qq2898498192-prog/codex/README.md

# Microduck 完整工程

## [进入完整工程 microduck_rl/](microduck_rl/)

已完整复制来源分支的 **253 个文件**，包括全部源码、STL、MJCF、图片、Gerber、BOM、贴片坐标、固件、测试、依赖文件、文档和许可证。保持原始目录、文件内容和文件模式。

- 来源：https://github.com/atrl/microduck_rl/tree/codex/organize-robot-assets-20260830
- 固定提交：`57280a07b06f7356500b796c8ddcda66008908d2`
- [文件 SHA-256 清单](MICRODUCK_IMPORT.json)
- Git 树校验：`microduck_rl/` 的树 SHA 为 `ccd966b7c30a4be1f8063402e468bb5402f9c3f4`，与来源提交根目录完全一致。

| 内容 | 入口 |
|---|---|
| 原工程说明及运行方式 | [README](microduck_rl/README.md) |
| 机器人模型、STL 与装配配置 | [模型目录](microduck_rl/src/mjlab_microduck/robot/microduck/) |
| 原理图图片、硬件 BOM 与接线 | [硬件目录](microduck_rl/docs/hardware/) |
| Gerber、贴片 BOM 与坐标 | [制造文件](microduck_rl/docs/hardware/manufacturing/) |
| IMU 固件 | [firmware](microduck_rl/firmware/) |
| 训练与仿真源码 | [src](microduck_rl/src/) |

本次复制的是指定分支提交的完整文件快照，不包含原仓库 Git 历史及外部 Onshape 文档本体。工程原有的未验证事项和许可保持不变；复制成功不代表已完成硬件制造验证。此前 references/ 中的部分摘录已由这里的完整工程取代。

## 新版宠物机器人设计（2026-09-09）

[新方案、效果图、修改与对话记录](projects/microduck-pet-v2/README.md)。当前为概念和布局归档，尚未完成高还原度CAD与交互装配模型。
