qq2898498192-prog/codex/references/microduck/README.zh-CN.md

# 已迁移到完整工程

## [打开完整 microduck_rl 工程](../../microduck_rl/)

指定分支固定提交 `57280a07b06f7356500b796c8ddcda66008908d2` 的 253 个文件已全部复制，包含 STL、图片、Gerber、贴片文件及完整代码。文件内容、目录和模式已通过 Git 树 SHA 核对。

当前目录中的 upstream 是早期部分摘录，个别文档经过删节；请以根目录 microduck_rl 中的完整原始文件为准。

[来源与完整性说明](../../README.md) · [文件校验清单](../../MICRODUCK_IMPORT.json)
