qq2898498192-prog/codex/projects/microduck-pet-v2/animation/README.md

# 视频复现
依赖Python、numpy、Pillow和系统ffmpeg。
`python render.py --font /path/to/NotoSansSC-Regular.ttf`
字体需自行提供有中文的合法字体；缺少中文字体可能出现方框。
轮滚子仅简化面片，不能按此做轮子。
