qq2898498192-prog/codex/projects/microduck-pet-v2/docs/CONVERSATION.md

# 新方案对话记录（可见内容整理）

归档日期：2026-09-09。

范围：机器人新ID、屏幕头、轮组、内部装配及交互爆炸阶段。下面引号中的用户句子按当前可见对话保留；“助手摘要”是归档整理，不冒充逐字回复。没有完整平台原始导出、每条时间戳或不可见的历史回复；未保存工具内部信息、授权凭据和本项目无关的个人历史。

## 起点与造型迭代

用户：
> OK，我现在不想完全复刻这个产品了，我希望从这里给一些启发和借鉴，并且想做另外一种玩具机器人，大体上就是，相比于双腿行走，我希望用四向转向轮，然后带一个屏幕可以显示表情，信息等等，带一个摄像头可以跟踪人，带一个跟鸭子一样的激光雷达。你先帮我设计一个大体的ID，我们再讨论改进

用户：
> 不想要这样的，我希望你能参考鸭子的想法，做一个宠物类的，而不是一个儿童玩具

用户：
> 好丑，你还是参考鸭子吧，做成可以直立行走的，并且是可行的，你这种ID不现实也不美观

用户：
> 更丑了

用户：
> 你还是用之前的鸭子的形象，只不过换一个头，头上多一个小尺寸的屏幕

助手摘要：尝试多个造型均未获认可，回到原版鸭子的身体、长颈和机械双腿，在额头加小屏。

用户：
> 继续

用户：
> 不要长这样的摄像头放小，屏幕大一点

助手摘要：缩小摄像头到屏幕上方，扩大屏幕，生成外观概念；未按实物模组冻结结构。

用户：
> 你要考虑模组的大小

助手摘要：承认之前仅外观效果，没有摄像头/屏幕整板、排线与安装结构约束。

用户：
> 你继续去设计

助手摘要：查阅屏幕79.9×50.8、摄像头25×24、ToF载板资料，制作头部V1正面与侧向布局；暂定头部110×92×80，不是可生产CAD。

用户：
> 设计效果呢

助手摘要：生成更宽黑色边框的屏幕头效果，显示区与模组整板区分。

## 轮子方案

用户：
> 这个鸭子有个轮子的方案，把脚换成他的轮子方案

助手摘要：参照仓库轮滑装配渲染生成效果图，声称每脚两个前后轮。

用户：
> 你确定这是他原来的方案吗，不是长这样的

助手摘要：承认AI图不是原版精确还原；检查robot_allcollisions_rollers.xml确认四个passive轮轴，仅能说明给定分支的配置。展示由STL/MJCF直接渲染的参考。

用户：
> 头先用回摄像头版本，脚不要舵机了做成万向轮

助手摘要：恢复摄像头头部，取消脚踝舵机，改固定脚架和4个被动万向脚轮；说明被动脚轮不供驱动力。

用户：
> 这样还是太丑了，整个脚的部分加装电机，改成大的麦克纳姆轮

助手摘要：生成四轮独立电机麦克纳姆足端，电机藏入轮罩；仍是外观概念。

用户：
> 腿部需要安装电机和线束，要重新设计，头换成屏幕方案，电机型号你要根据实际可能得重量去设计，头的嘴就不需要了，也不需要用舵机了

助手摘要：按取消嘴部舵机理解，暂保留头部俯仰与转向；查阅Pololu4846，按3kg和80mm轮初选，增加腿壳/横撑/走线。此处保留俯仰随后被用户明确纠正。

用户：
> 轮子太大了，选用小轮子吧

助手摘要：按约60mm比例生成小轮图；不代表最终型号和尺寸已锁定。

用户：
> 没有区别啊，把头的嘴巴去掉，头不需要前后前仰了，只要左右能扭头就行了。你做一个演示视频出来

助手摘要：改为头壳无独立下颌、竖直单轴转台。制作10秒、240帧、1280×900的简化三维转头视频，左右±35°，不做点头；不是此前图片精度的动画。

## 内部器件与爆炸图

用户：
> 你做一个爆炸图，包括内部器件的摆放位置，如果你没有考虑到或者漏了你就重新设计

助手摘要：补齐主控、电池、配电、脚部驱动板、转台执行器/承重轴承、轮轴/联轴器、检修与线束空间；生成42项包络布局。电机横置导致底宽294mm，重量预算改3.5kg。部分器件仅占位；无完整CAD、PCB、STL。

用户：
> 要整个效果的爆炸图纸

助手摘要：生成整机视觉爆炸图。第一张错误生成8轮，后续改成4轮。图中连接、紧固和机械细节仍为生成式示意，无对应精确CAD。

用户：
> 能不能做成那种原本是一个整体，然后我拖动可以打开整体或者部分地方的爆炸效果的

助手摘要：制作Three.js简化模型，默认装配、选择整机/头/转台/躯干/左右腿脚、滑块展开、旋转/缩放、一键复位。只验证JS与桩环境回调，未跑真实WebGL浏览器验证。

用户：
> 我要基于这个做的拖动爆炸效果图

附件：用户重新贴出整机爆炸效果图，对应本归档 concepts/exec-45c2b3f4-eb2d-42fb-9c85-e57055dfe0b6.png 的视觉目标。

助手摘要：明确用户要同一外观和内部零件形状的交互模型，之前简化模型不符合要求。承认效果图背后没有对应真实三维件，必须重建；切块图片移动不能替代真实可旋转装配。

## GitHub归档授权

用户：
> 你把新的设计方案放进我的github上，也可以建立一个新的分支，并且需要把修改和对话记录放进github上

用户随后重复同一请求。

助手归档范围：用户仓库qq2898498192-prog/codex，新分支codex/screen-mecanum-design-20260909；保留新方案、历史图、布局和演示源码、修改日志、对话整理、未完成清单。没有完成/声称高还原度三维重建，也不改动原microduck_rl工程。
