qq2898498192-prog/codex/projects/microduck-pet-v2/scripts/archive/README.md

历史生成脚本原样存档；含会话绝对路径，复现前需调整字体/路径。layout/中的产物为归档事实。不要运行脚本覆盖新设计。
