qq2898498192-prog/codex/microduck_rl/docs/hardware/imu_to_dxl_v0_schematic.png

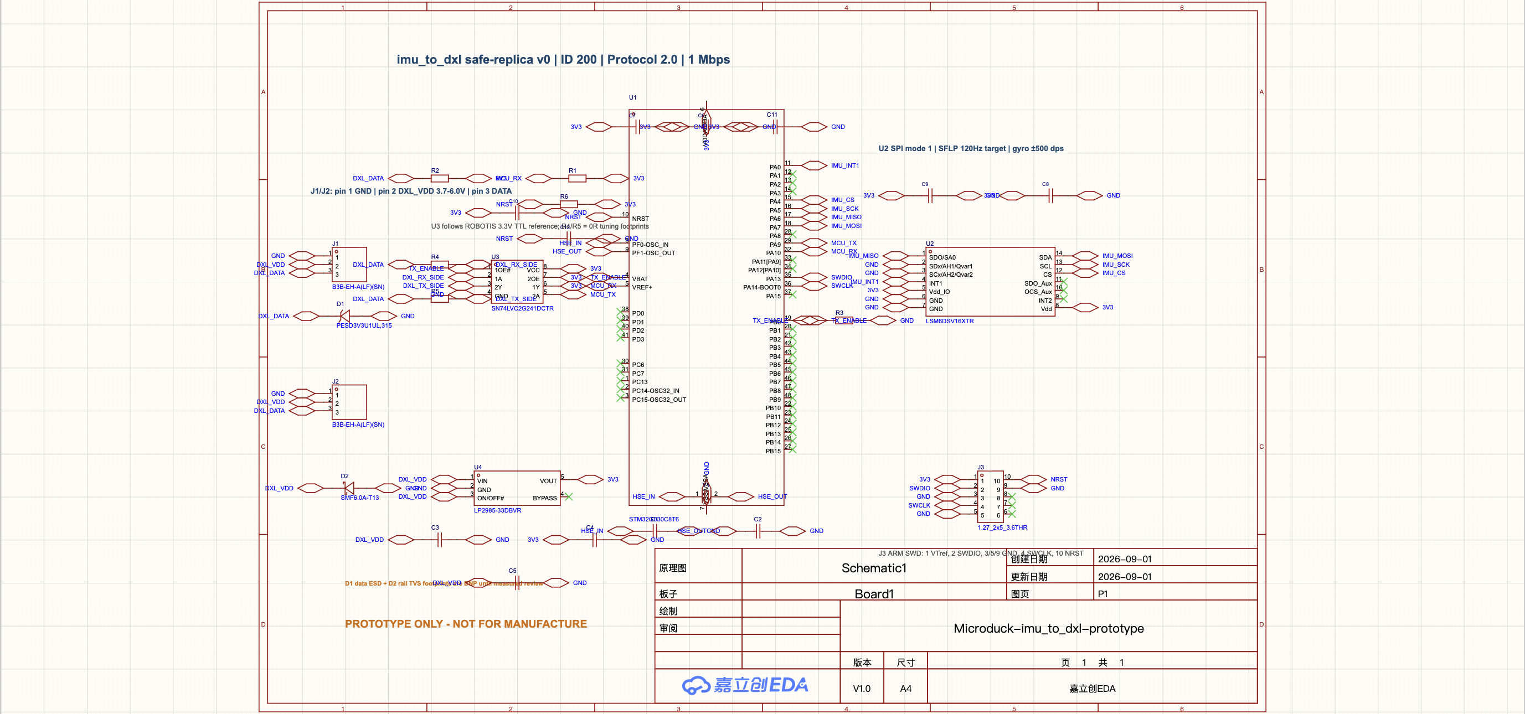
microduck_rl/docs/hardware/imu_to_dxl_v0_schematic.png
