qq2898498192-prog/codex/projects/microduck-pet-v2/animation/preview.png

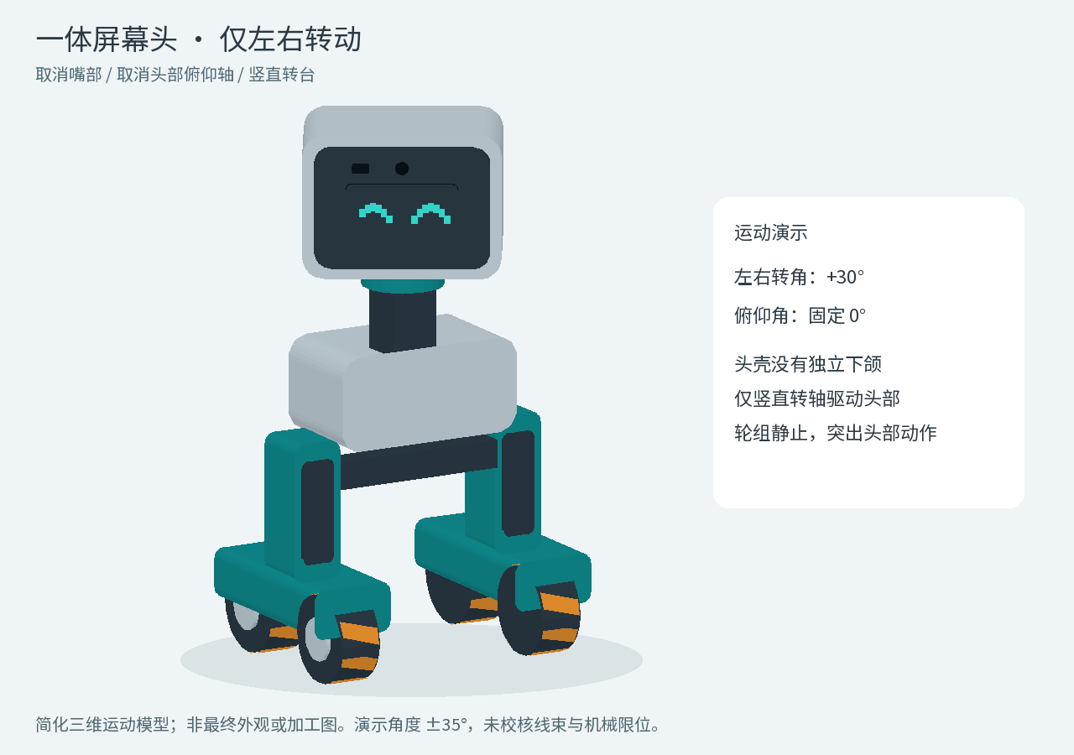
projects/microduck-pet-v2/animation/preview.png
