qq2898498192-prog/codex/projects/microduck-pet-v2/concepts/exec-0cad2724-1c27-4ab0-85ad-87070f33ec14.png

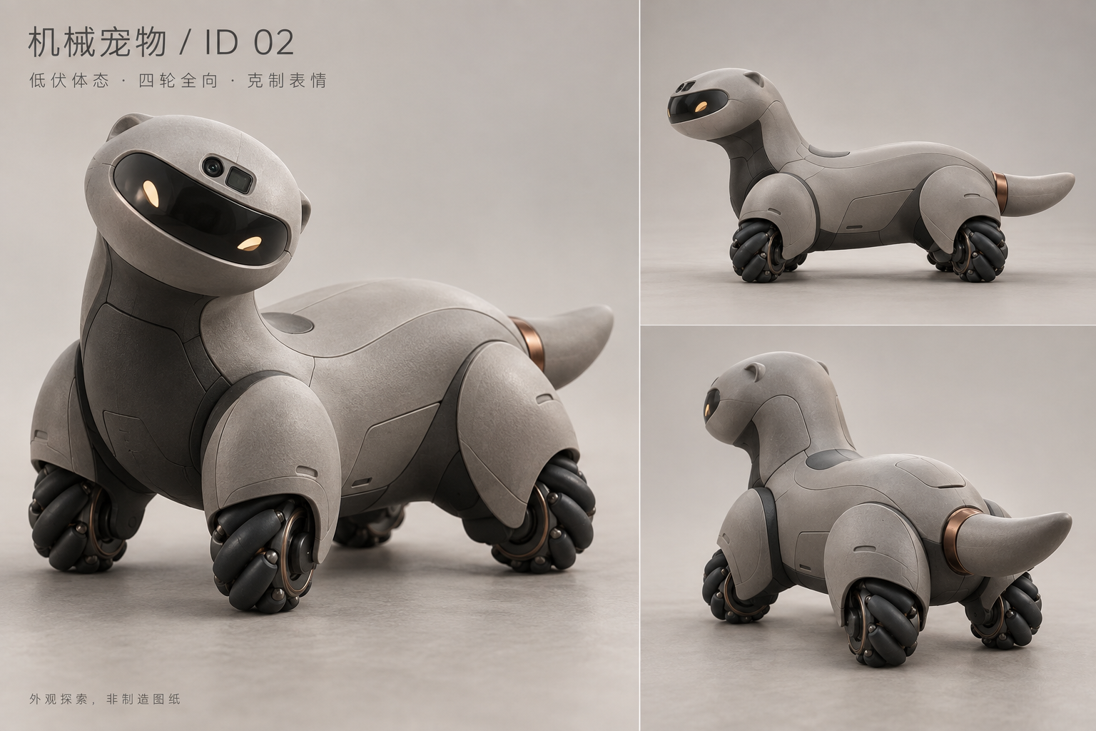
projects/microduck-pet-v2/concepts/exec-0cad2724-1c27-4ab0-85ad-87070f33ec14.png
