qq2898498192-prog/codex/projects/microduck-pet-v2/concepts/exec-01a4c43e-ca88-4873-aa00-53a5d9657a6b.png

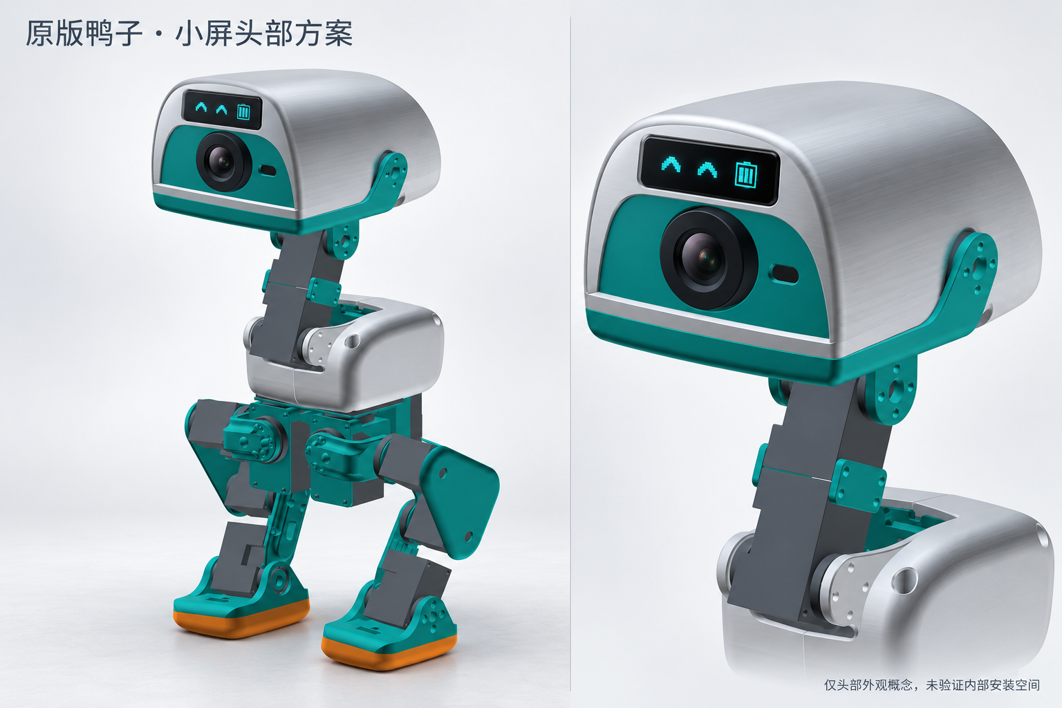
projects/microduck-pet-v2/concepts/exec-01a4c43e-ca88-4873-aa00-53a5d9657a6b.png
