qq2898498192-prog/codex/projects/microduck-pet-v2/concepts/exec-12abe6a6-0537-42fc-a870-e68644018d23.png

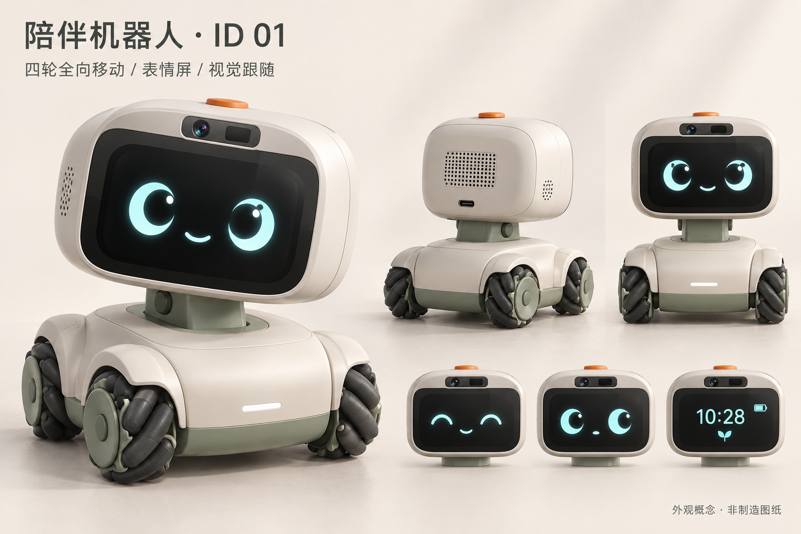
projects/microduck-pet-v2/concepts/exec-12abe6a6-0537-42fc-a870-e68644018d23.png
