qq2898498192-prog/codex/projects/microduck-pet-v2/concepts/exec-36e8b0e3-2273-436e-a0a7-a6f0dd408338.png

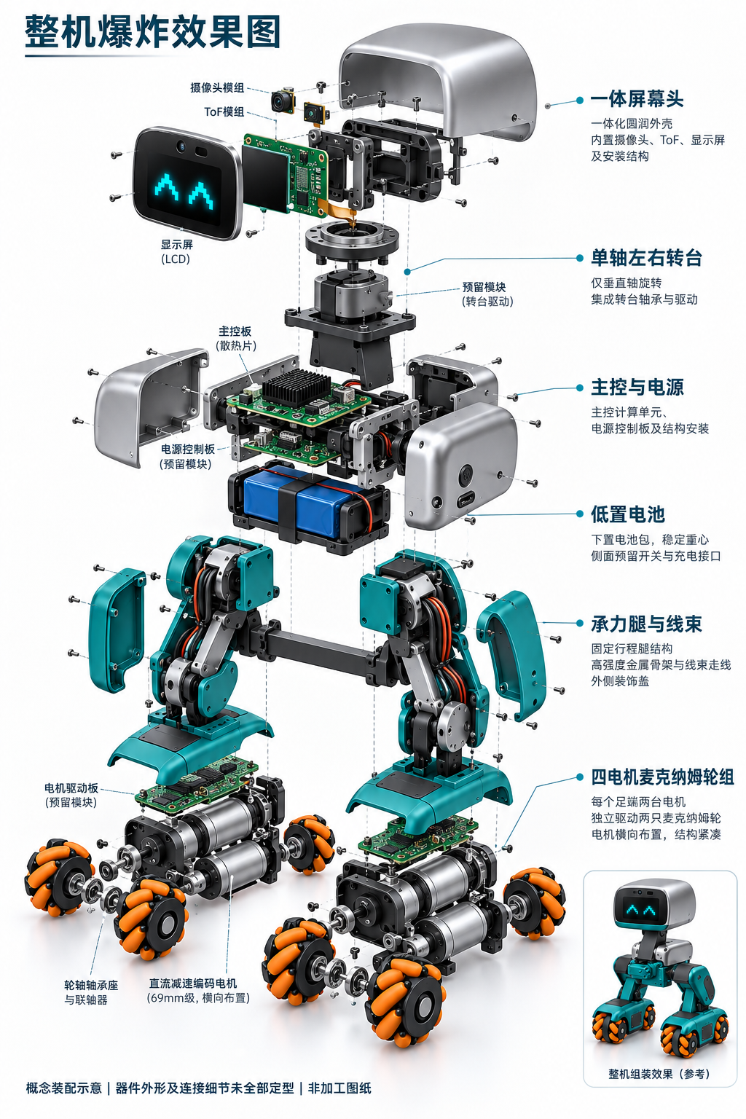
projects/microduck-pet-v2/concepts/exec-36e8b0e3-2273-436e-a0a7-a6f0dd408338.png
