qq2898498192-prog/codex/projects/microduck-pet-v2/concepts/exec-545a0076-77d6-4a2a-9751-2d3e98dc3354.png

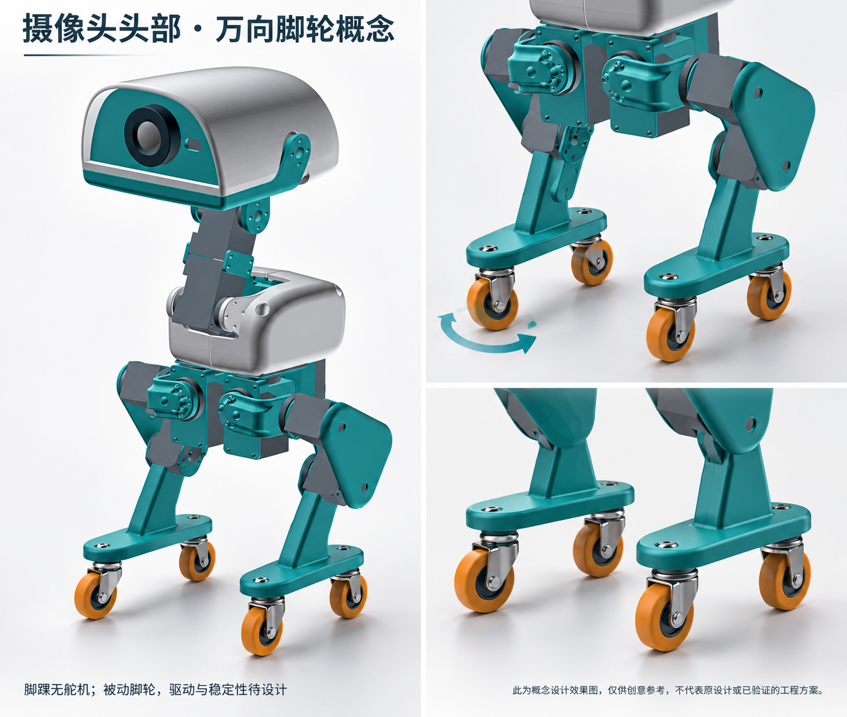
projects/microduck-pet-v2/concepts/exec-545a0076-77d6-4a2a-9751-2d3e98dc3354.png
