qq2898498192-prog/codex/projects/microduck-pet-v2/concepts/exec-1944f9b6-d83f-42fd-b372-9bee85fd1d9c.png

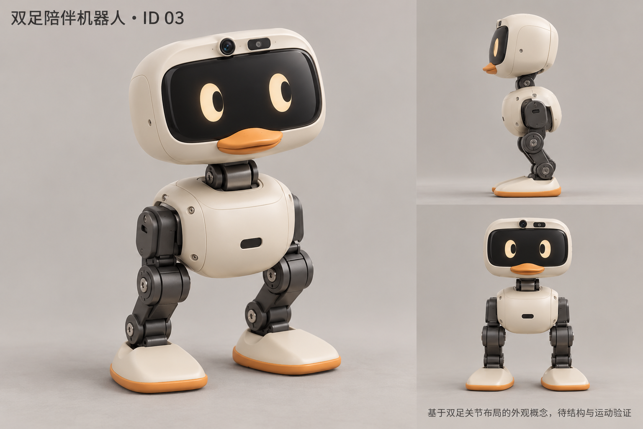
projects/microduck-pet-v2/concepts/exec-1944f9b6-d83f-42fd-b372-9bee85fd1d9c.png
