qq2898498192-prog/codex/projects/microduck-pet-v2/concepts/exec-84887840-35ca-4b33-ac52-a1b6fc9ca3c3.png

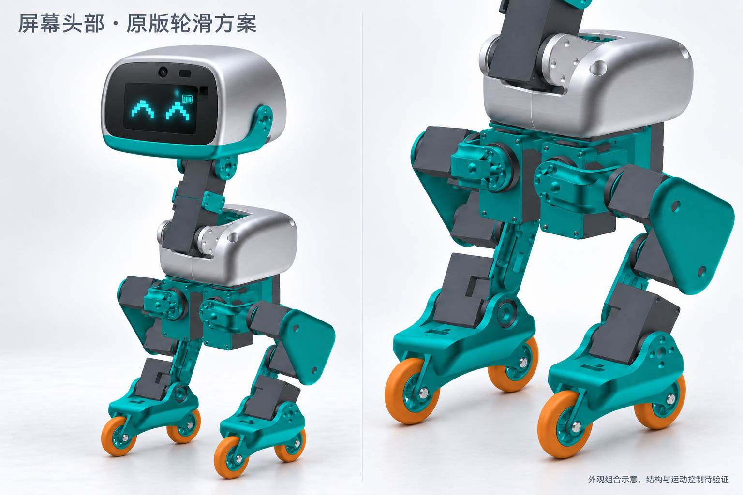
projects/microduck-pet-v2/concepts/exec-84887840-35ca-4b33-ac52-a1b6fc9ca3c3.png
