qq2898498192-prog/codex/projects/microduck-pet-v2/concepts/exec-c1b9ecd1-bf93-4650-8cc1-9218ce18c52f.png

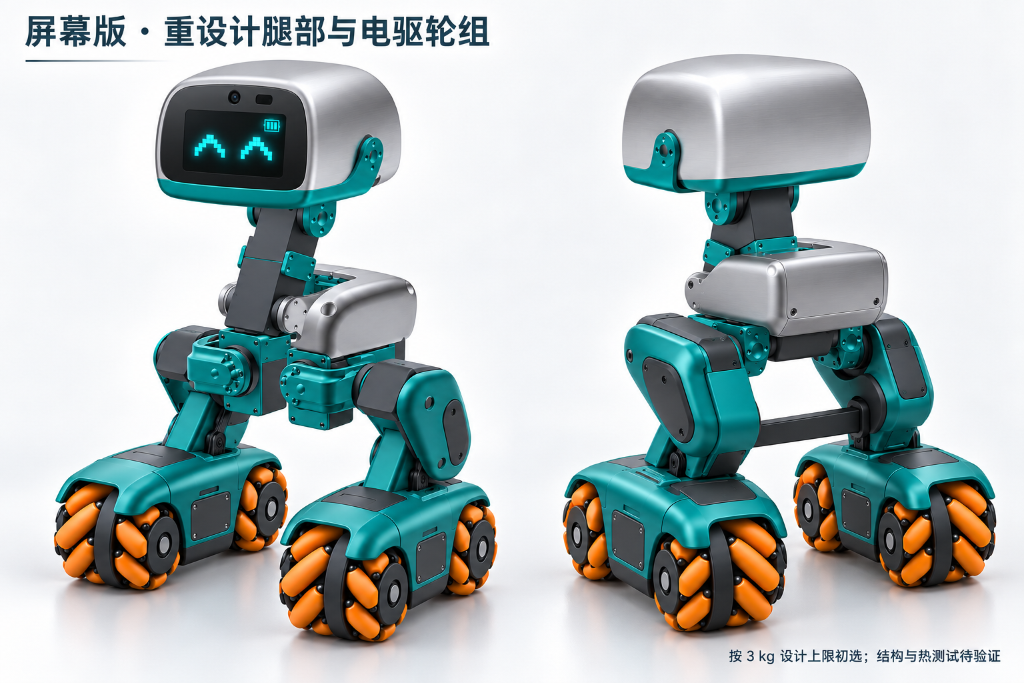
projects/microduck-pet-v2/concepts/exec-c1b9ecd1-bf93-4650-8cc1-9218ce18c52f.png
