qq2898498192-prog/codex/projects/microduck-pet-v2/concepts/exec-c386e710-e0e7-46d0-af4a-2715de877a2f.png

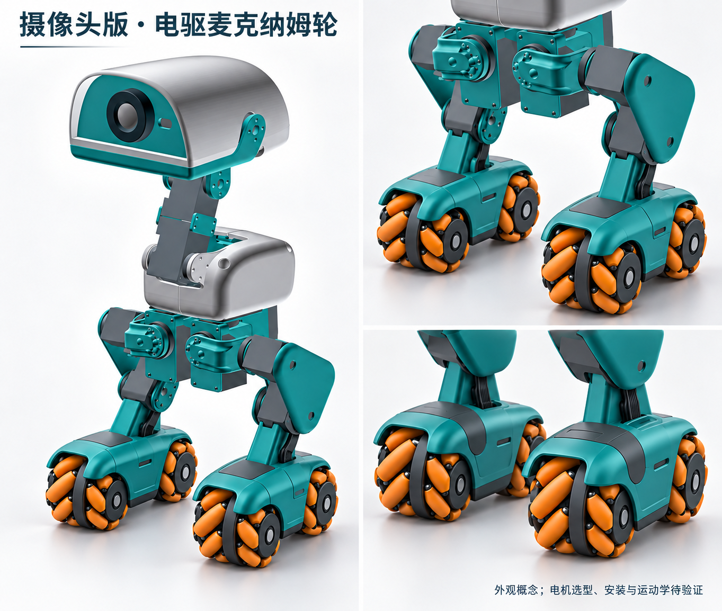
projects/microduck-pet-v2/concepts/exec-c386e710-e0e7-46d0-af4a-2715de877a2f.png
