qq2898498192-prog/codex/projects/microduck-pet-v2/concepts/exec-febafb0e-33c4-49e8-8c32-e0713513a3d7.png

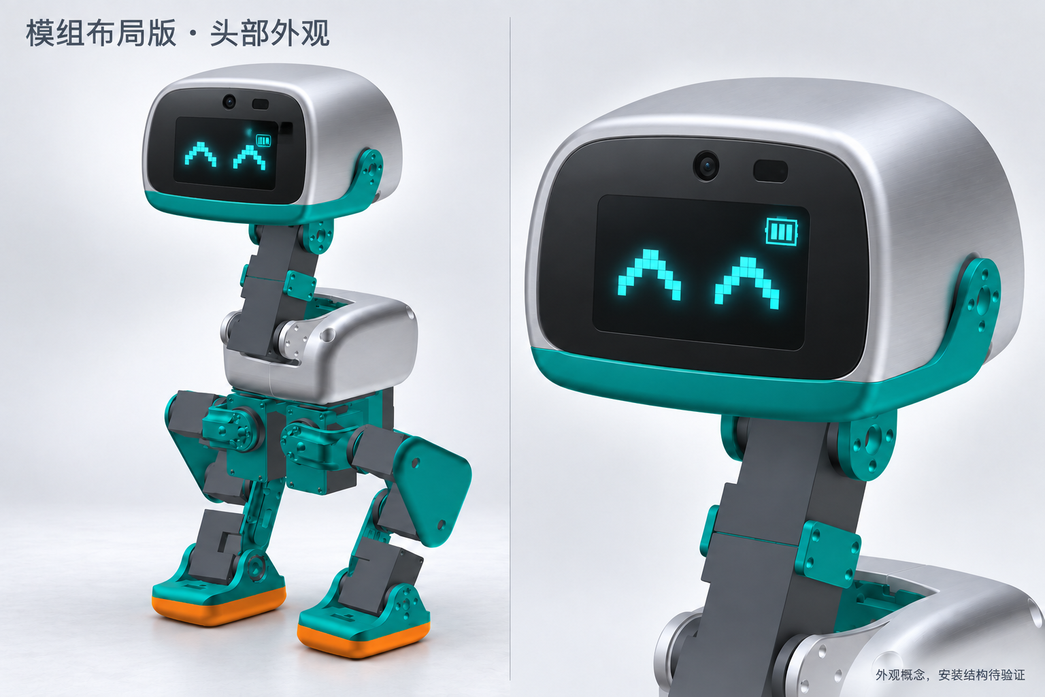
projects/microduck-pet-v2/concepts/exec-febafb0e-33c4-49e8-8c32-e0713513a3d7.png
