qq2898498192-prog/codex/projects/microduck-pet-v2/layout/Exploded_Preview.png

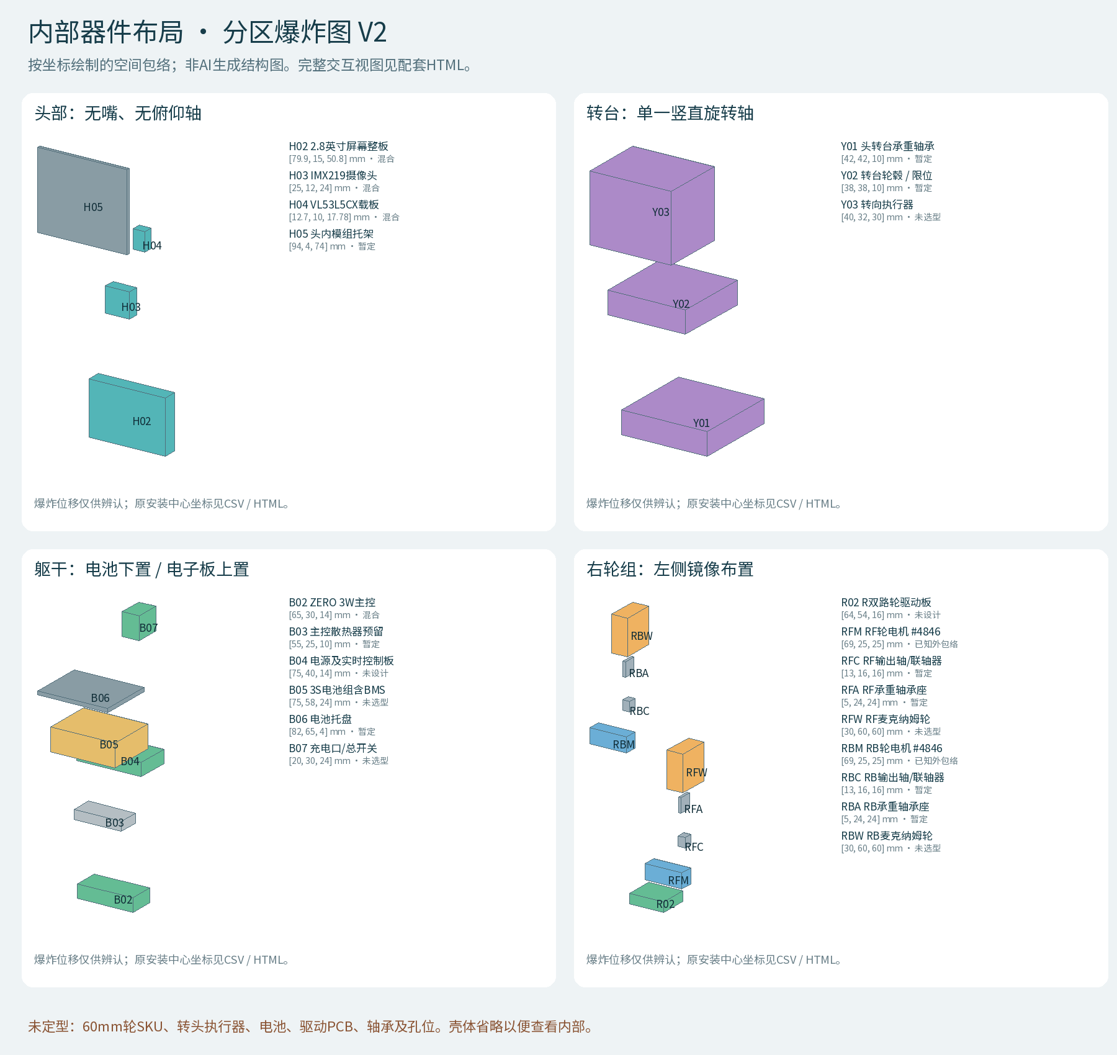
projects/microduck-pet-v2/layout/Exploded_Preview.png
