qq2898498192-prog/codex/microduck_rl/docs/hardware/reference_bom.csv

item_id | variant | subsystem | item_name | specification | source_asset | procurement_class | status | confidence | verification_gate | source_url | notes
M008 | both | electronics | Robot HAT PCB envelope | Reference geometry only | elec_rpi_robot_hat_pcb.stl | reference_only | reference_only | medium | Compare replacement HAT outline and hole locations | https://github.com/pollen-robotics/microduck_rl/tree/develop/src/mjlab_microduck/robot/microduck/assets | Do not print as a PCB
M016 | both | legacy | Older left upper leg export | Unreferenced legacy mesh | left_upper_leg.stl | legacy | legacy | high | Confirm it stays unused | https://github.com/pollen-robotics/microduck_rl/tree/develop/src/mjlab_microduck/robot/microduck/assets | Do not print for current assemblies
M018 | both | electronics | Camera lens envelope | Reference geometry only | lens.stl | reference_only | reference_only | low | Confirm actual camera and lens before purchase | https://github.com/pollen-robotics/microduck_rl/tree/develop/src/mjlab_microduck/robot/microduck/assets | May represent prototype M12 optics
M024 | both | power | NP-F battery envelope | NP-F970 reference envelope | np_f970.stl | reference_only | reference_only | medium | Select NP-F550 or NP-F970 after mass and clearance test | https://github.com/pollen-robotics/microduck_rl/tree/develop/src/mjlab_microduck/robot/microduck/assets | Runtime names NP-F550 while the mesh is NP-F970
M025 | both | electronics | Raspberry Pi Zero 2 W envelope | Prototype reference only | pcb__raspberry_pi_zero_2_w.stl | reference_only | reference_only | high | Do not purchase for current runtime target | https://github.com/pollen-robotics/microduck/blob/main/docs/design/robotd-design.md | Current alpha runtime uses Radxa Zero 3W
M028 | both | legacy | Older right upper leg export | Unreferenced legacy mesh | right_upper_leg.stl | legacy | legacy | high | Confirm it stays unused | https://github.com/pollen-robotics/microduck_rl/tree/develop/src/mjlab_microduck/robot/microduck/assets | Do not print for current assemblies
M040 | both | legacy | Older left trunk shell export | Unreferenced legacy mesh | trunk_shell_left.stl | legacy | legacy | high | Confirm it stays unused | https://github.com/pollen-robotics/microduck_rl/tree/develop/src/mjlab_microduck/robot/microduck/assets | Do not print for current assemblies
M041 | both | legacy | Older right trunk shell export | Unreferenced legacy mesh | trunk_shell_right.stl | legacy | legacy | high | Confirm it stays unused | https://github.com/pollen-robotics/microduck_rl/tree/develop/src/mjlab_microduck/robot/microduck/assets | Do not print for current assemblies
