qq2898498192-prog/codex/microduck_rl/docs/hardware/microduck_bom.csv

item_id | variant | subsystem | item_name | specification | source_asset | base_qty | roller_qty | purchase_qty | unit | procurement_class | status | confidence | verification_gate | source_url | notes | buy_status | preferred_url | alternate_url | link_type | link_checked_on | next_action | purchase_notes
M001 | roller | feet | Roller left ankle | Simulation-derived rigid print | ankle_l_v1.stl | 0 | 1 |  | piece | print_rigid | confirmed_model | medium | Fit-check against servo and roller chassis | https://github.com/pollen-robotics/microduck_rl/tree/develop/src/mjlab_microduck/robot/microduck/assets | Roller model only
M002 | walking | feet | Walking left ankle | Simulation-derived rigid print | ankle_left.stl | 1 | 0 |  | piece | print_rigid | confirmed_model | medium | Fit-check bearing and servo interfaces | https://github.com/pollen-robotics/microduck_rl/tree/develop/src/mjlab_microduck/robot/microduck/assets | Walking model only
M003 | roller | feet | Roller right ankle | Simulation-derived rigid print | ankle_r_v1.stl | 0 | 1 |  | piece | print_rigid | confirmed_model | medium | Fit-check against servo and roller chassis | https://github.com/pollen-robotics/microduck_rl/tree/develop/src/mjlab_microduck/robot/microduck/assets | Roller model only
M004 | walking | feet | Walking right ankle | Simulation-derived rigid print | ankle_right.stl | 1 | 0 |  | piece | print_rigid | confirmed_model | medium | Fit-check bearing and servo interfaces | https://github.com/pollen-robotics/microduck_rl/tree/develop/src/mjlab_microduck/robot/microduck/assets | Walking model only
M005 | both | electronics_mounts | PCB retainer | Simulation-derived rigid print | banana_pcb_locker.stl | 1 | 1 |  | piece | print_rigid | confirmed_model | medium | Fit-check against selected HAT PCB | https://github.com/pollen-robotics/microduck_rl/tree/develop/src/mjlab_microduck/robot/microduck/assets | May require redesign for replacement HAT
M006 | both | hips | Hip bearing support | Simulation-derived rigid print | bearing_roll.stl | 2 | 2 |  | piece | print_rigid | confirmed_model | medium | Fit-check bearing press and M2 holes | https://github.com/pollen-robotics/microduck_rl/tree/develop/src/mjlab_microduck/robot/microduck/assets | One per side
M007 | both | head | Lower head shell | Simulation-derived rigid print | bottom_head_shell.stl | 1 | 1 |  | piece | print_rigid | confirmed_model | medium | Check shell closure and cable clearance | https://github.com/pollen-robotics/microduck_rl/tree/develop/src/mjlab_microduck/robot/microduck/assets
M008 | both | electronics | Robot HAT PCB envelope | Reference geometry only | elec_rpi_robot_hat_pcb.stl | 0 | 0 |  | piece | reference_only | reference_only | medium | Compare replacement HAT outline and hole locations | https://github.com/pollen-robotics/microduck_rl/tree/develop/src/mjlab_microduck/robot/microduck/assets | Do not print as a PCB
M009 | both | head | Face structure | Simulation-derived rigid print | face_part.stl | 1 | 1 |  | piece | print_rigid | confirmed_model | medium | Fit-check sensors and mouth travel | https://github.com/pollen-robotics/microduck_rl/tree/develop/src/mjlab_microduck/robot/microduck/assets
M010 | walking | feet | Walking left foot | Simulation-derived rigid print | foot_left.stl | 1 | 0 |  | piece | print_rigid | confirmed_model | medium | Fit-check sole and ankle | https://github.com/pollen-robotics/microduck_rl/tree/develop/src/mjlab_microduck/robot/microduck/assets | Walking model only
M011 | walking | feet | Walking right foot | Simulation-derived rigid print | foot_right.stl | 1 | 0 |  | piece | print_rigid | confirmed_model | medium | Fit-check sole and ankle | https://github.com/pollen-robotics/microduck_rl/tree/develop/src/mjlab_microduck/robot/microduck/assets | Walking model only
M012 | both | hips | Hip structure | Simulation-derived rigid print | hip_l.stl | 2 | 2 |  | piece | print_rigid | confirmed_model | medium | Verify mirrored assembly and bearing support | https://github.com/pollen-robotics/microduck_rl/tree/develop/src/mjlab_microduck/robot/microduck/assets | Same mesh used on both sides
M013 | both | head | Jaw structure | Simulation-derived rigid print | jaw.stl | 1 | 1 |  | piece | print_rigid | confirmed_model | medium | Verify mouth linkage and ID34 servo interface | https://github.com/pollen-robotics/microduck_rl/tree/develop/src/mjlab_microduck/robot/microduck/assets | Mouth actuation is not represented as a controlled MJCF joint
M014 | both | head | Soft lower mouth | Flexible print candidate | jaw_soft.stl | 1 | 1 |  | piece | print_flexible | confirmed_model | low | Print TPU coupon and verify grip and travel | https://github.com/pollen-robotics/microduck_rl/tree/develop/src/mjlab_microduck/robot/microduck/assets | Material is inferred
M015 | both | body | Left body shell | Simulation-derived rigid print | left_shell.stl | 1 | 1 |  | piece | print_rigid | confirmed_model | medium | Check shell closure after harness installation | https://github.com/pollen-robotics/microduck_rl/tree/develop/src/mjlab_microduck/robot/microduck/assets
M016 | both | legacy | Older left upper leg export | Unreferenced legacy mesh | left_upper_leg.stl | 0 | 0 |  | piece | legacy | legacy | high | Confirm it stays unused | https://github.com/pollen-robotics/microduck_rl/tree/develop/src/mjlab_microduck/robot/microduck/assets | Do not print for current assemblies
M017 | both | legs | Lower leg | Simulation-derived rigid print | leg.stl | 2 | 2 |  | piece | print_rigid | confirmed_model | medium | Verify knee and ankle interfaces | https://github.com/pollen-robotics/microduck_rl/tree/develop/src/mjlab_microduck/robot/microduck/assets | Same mesh used on both sides
M018 | both | electronics | Camera lens envelope | Reference geometry only | lens.stl | 0 | 0 |  | piece | reference_only | reference_only | low | Confirm actual camera and lens before purchase | https://github.com/pollen-robotics/microduck_rl/tree/develop/src/mjlab_microduck/robot/microduck/assets | May represent prototype M12 optics
M019 | both | electronics_mounts | M12 lens holder | Simulation-derived rigid print | m12_lens_holder.stl | 1 | 1 |  | piece | print_rigid | confirmed_model | low | Confirm selected camera and focal length | https://github.com/pollen-robotics/microduck_rl/tree/develop/src/mjlab_microduck/robot/microduck/assets | May need redesign for IMX219 module
M020 | both | head | Jaw motor support | Simulation-derived rigid print | motor_support.stl | 1 | 1 |  | piece | print_rigid | confirmed_model | medium | Verify ID34 servo and linkage alignment | https://github.com/pollen-robotics/microduck_rl/tree/develop/src/mjlab_microduck/robot/microduck/assets
M021 | both | neck | Neck side structure | Simulation-derived rigid print | neck.stl | 2 | 2 |  | piece | print_rigid | confirmed_model | medium | Verify paired parts and bearing alignment | https://github.com/pollen-robotics/microduck_rl/tree/develop/src/mjlab_microduck/robot/microduck/assets | Two instances
M022 | both | neck | Neck pitch structure | Simulation-derived rigid print | neck_pitch.stl | 1 | 1 |  | piece | print_rigid | confirmed_model | medium | Verify head-pitch axis | https://github.com/pollen-robotics/microduck_rl/tree/develop/src/mjlab_microduck/robot/microduck/assets
M023 | both | head | Eye-area cosmetic insert | Simulation-derived rigid print | noenoeil.stl | 1 | 1 |  | piece | print_rigid | confirmed_model | low | Confirm cosmetic requirement and sensor clearance | https://github.com/pollen-robotics/microduck_rl/tree/develop/src/mjlab_microduck/robot/microduck/assets
M024 | both | power | NP-F battery envelope | NP-F970 reference envelope | np_f970.stl | 0 | 0 |  | piece | reference_only | reference_only | medium | Select NP-F550 or NP-F970 after mass and clearance test | https://github.com/pollen-robotics/microduck_rl/tree/develop/src/mjlab_microduck/robot/microduck/assets | Runtime names NP-F550 while the mesh is NP-F970
M025 | both | electronics | Raspberry Pi Zero 2 W envelope | Prototype reference only | pcb__raspberry_pi_zero_2_w.stl | 0 | 0 |  | piece | reference_only | reference_only | high | Do not purchase for current runtime target | https://github.com/pollen-robotics/microduck/blob/main/docs/design/robotd-design.md | Current alpha runtime uses Radxa Zero 3W
M026 | both | electronics_mounts | Power and battery support | Simulation-derived rigid print | power_support.stl | 1 | 1 |  | piece | print_rigid | confirmed_model | medium | Fit-check selected battery and safe power board | https://github.com/pollen-robotics/microduck_rl/tree/develop/src/mjlab_microduck/robot/microduck/assets | May require redesign
M027 | both | body | Right body shell | Simulation-derived rigid print | right_shell.stl | 1 | 1 |  | piece | print_rigid | confirmed_model | medium | Check shell closure after harness installation | https://github.com/pollen-robotics/microduck_rl/tree/develop/src/mjlab_microduck/robot/microduck/assets
M028 | both | legacy | Older right upper leg export | Unreferenced legacy mesh | right_upper_leg.stl | 0 | 0 |  | piece | legacy | legacy | high | Confirm it stays unused | https://github.com/pollen-robotics/microduck_rl/tree/develop/src/mjlab_microduck/robot/microduck/assets | Do not print for current assemblies
M029 | roller | roller | Wheel rim | Simulation-derived rigid print | rim.stl | 0 | 4 |  | piece | print_rigid | confirmed_model | medium | Verify axle and tire fit | https://github.com/pollen-robotics/microduck_rl/tree/develop/src/mjlab_microduck/robot/microduck/assets | Four wheels
M030 | roller | roller | Roller chassis | Simulation-derived rigid print | roller_blade.stl | 0 | 2 |  | piece | print_rigid | confirmed_model | medium | Verify ankle and wheel clearances | https://github.com/pollen-robotics/microduck_rl/tree/develop/src/mjlab_microduck/robot/microduck/assets | One per foot
M031 | both | mechanical | Large bearing | 16 mm ID x 22 mm OD x 4 mm | seeed_bearing__configuration__22x16x4.stl | 11 | 11 | 13 | piece | purchase | confirmed_model | medium | Measure actual seat and verify bearing type before bulk order | https://github.com/fanhao375/microduck-replica/blob/master/docs/%E7%B4%A7%E5%9B%BA%E4%BB%B6%E5%8F%8D%E6%8E%A8.md | Purchase quantity includes two spares | verify_before_buy | https://www.aliexpress.com/wholesale?SearchText=16x22x4+bearing |  | marketplace_search | 2026-08-31 | Complete the verification gate then order only the matching revision | Confirm bearing construction seal and measured seat before ordering
M032 | both | mechanical | Small bearing | approximately 10 mm ID x 15 mm OD x 3 mm | seeed_bearing__configuration_default.stl | 3 | 3 | 5 | piece | purchase | confirmed_model | medium | Measure actual seat and verify bearing type before bulk order | https://github.com/fanhao375/microduck-replica/blob/master/docs/%E7%B4%A7%E5%9B%BA%E4%BB%B6%E5%8F%8D%E6%8E%A8.md | Purchase quantity includes two spares | verify_before_buy | https://www.aliexpress.com/wholesale?SearchText=10x15x3+bearing |  | marketplace_search | 2026-08-31 | Complete the verification gate then order only the matching revision | Inner diameter is approximate and must be measured first
M033 | both | head | Soft upper mouth | Flexible print candidate | soft_mouth_top.stl | 1 | 1 |  | piece | print_flexible | confirmed_model | low | Print TPU coupon and verify grip and travel | https://github.com/pollen-robotics/microduck_rl/tree/develop/src/mjlab_microduck/robot/microduck/assets | Material is inferred
M034 | walking | feet | Walking left sole | Flexible print candidate | sole_left.stl | 1 | 0 |  | piece | print_flexible | confirmed_model | low | Print friction and compression coupons | https://github.com/pollen-robotics/microduck_rl/tree/develop/src/mjlab_microduck/robot/microduck/assets | Walking model only
M035 | walking | feet | Walking right sole | Flexible print candidate | sole_right.stl | 1 | 0 |  | piece | print_flexible | confirmed_model | low | Print friction and compression coupons | https://github.com/pollen-robotics/microduck_rl/tree/develop/src/mjlab_microduck/robot/microduck/assets | Walking model only
M036 | both | audio | Speaker | Envelope approximately 35 x 25 x 7 mm | speaker.stl | 1 | 1 | 2 | piece | purchase | needs_confirmation | low | Measure impedance power and mounting before purchase | https://github.com/pollen-robotics/microduck_rl/tree/develop/src/mjlab_microduck/robot/microduck/assets | Purchase quantity includes one spare but electrical model is unknown | do_not_buy |  |  | none | 2026-08-31 | Do not order; replace with a designed or confirmed alternative | Envelope exists but impedance power connector and acoustic requirements are unknown
M037 | roller | roller | Roller tire | Flexible print candidate | tire.stl | 0 | 4 |  | piece | print_flexible | confirmed_model | low | Print TPU durometer coupons and rolling test | https://github.com/pollen-robotics/microduck_rl/tree/develop/src/mjlab_microduck/robot/microduck/assets | Four wheels
M038 | both | head | Upper head shell | Simulation-derived rigid print | top_head_shell.stl | 1 | 1 |  | piece | print_rigid | confirmed_model | medium | Check shell closure and cable clearance | https://github.com/pollen-robotics/microduck_rl/tree/develop/src/mjlab_microduck/robot/microduck/assets
M039 | both | body | Trunk base | Simulation-derived rigid print | trunk_base.stl | 1 | 1 |  | piece | print_rigid | confirmed_model | medium | Verify all hip neck and electronics interfaces | https://github.com/pollen-robotics/microduck_rl/tree/develop/src/mjlab_microduck/robot/microduck/assets
M040 | both | legacy | Older left trunk shell export | Unreferenced legacy mesh | trunk_shell_left.stl | 0 | 0 |  | piece | legacy | legacy | high | Confirm it stays unused | https://github.com/pollen-robotics/microduck_rl/tree/develop/src/mjlab_microduck/robot/microduck/assets | Do not print for current assemblies
M041 | both | legacy | Older right trunk shell export | Unreferenced legacy mesh | trunk_shell_right.stl | 0 | 0 |  | piece | legacy | legacy | high | Confirm it stays unused | https://github.com/pollen-robotics/microduck_rl/tree/develop/src/mjlab_microduck/robot/microduck/assets | Do not print for current assemblies
M042 | both | legs | Left upper leg | Simulation-derived rigid print | upper_leg_left.stl | 1 | 1 |  | piece | print_rigid | confirmed_model | medium | Verify hip-pitch and knee interfaces | https://github.com/pollen-robotics/microduck_rl/tree/develop/src/mjlab_microduck/robot/microduck/assets
M043 | both | legs | Right upper leg | Simulation-derived rigid print | upper_leg_right.stl | 1 | 1 |  | piece | print_rigid | confirmed_model | medium | Verify hip-pitch and knee interfaces | https://github.com/pollen-robotics/microduck_rl/tree/develop/src/mjlab_microduck/robot/microduck/assets
M044 | both | legs | Upper-leg rigidity plate | Simulation-derived rigid print | upper_leg_rigidity_plate.stl | 2 | 2 |  | piece | print_rigid | confirmed_model | medium | Verify fastener stack and cable clearance | https://github.com/pollen-robotics/microduck_rl/tree/develop/src/mjlab_microduck/robot/microduck/assets | One per side
M045 | both | actuators | Dynamixel XL330-M288-T | TTL 3-pin servo | xl330.stl | 15 | 15 | 18 | piece | purchase | confirmed_runtime | high | Configure and bench-test each servo at rated voltage | https://en.robotis.com/shop_en/item.php?it_id=902-0163-000 | Fifteen installed plus three spares; each retail package lists one 180 mm X3P cable plus six M2x6 and ten M2x8 bolts | ready_to_buy | https://en.robotis.com/shop_en/item.php?it_id=902-0163-000 | https://www.robotis.us/dynamixel-xl330-m288-t/ | manufacturer_shop | 2026-08-31 | Confirm regional stock and delivery then order the exact item | Exact model; check regional stock and remember retail input is 3.7 to 6.0 V
M046 | both | hips | Hip yaw-to-roll bracket | Simulation-derived rigid print | yaw2roll.stl | 2 | 2 |  | piece | print_rigid | confirmed_model | medium | Verify mirrored assembly and servo horn alignment | https://github.com/pollen-robotics/microduck_rl/tree/develop/src/mjlab_microduck/robot/microduck/assets | One per side
M047 | both | neck | Head yaw-roll linkage | Simulation-derived rigid print | yaw_roll_motion.stl | 1 | 1 |  | piece | print_rigid | confirmed_model | medium | Verify both axes and cable twist range | https://github.com/pollen-robotics/microduck_rl/tree/develop/src/mjlab_microduck/robot/microduck/assets
F001 | both | fasteners | M2 x 4 socket-head screws | M2 metric socket-head |  | 0 | 0 | 60 | piece | consumable | inferred | low | Confirm each stack with printed coupons and calipers | https://github.com/fanhao375/microduck-replica/blob/master/docs/%E7%B4%A7%E5%9B%BA%E4%BB%B6%E5%8F%8D%E6%8E%A8.md | Stock quantity includes loss and is not installed count | verify_before_buy | https://www.aliexpress.com/wholesale?SearchText=M2x4+socket+head+screw |  | marketplace_search | 2026-08-31 | Complete the verification gate then order only the matching revision | Buy only after installed fastener schedule is dry-fit
F002 | both | fasteners | M2 x 6 socket-head screws | M2 metric socket-head |  | 0 | 0 | 80 | piece | consumable | inferred | low | Confirm each stack with printed coupons and calipers | https://github.com/fanhao375/microduck-replica/blob/master/docs/%E7%B4%A7%E5%9B%BA%E4%BB%B6%E5%8F%8D%E6%8E%A8.md | Stock quantity includes loss and is not installed count | inventory_included_first | https://en.robotis.com/shop_en/item.php?it_id=902-0163-000 | https://www.aliexpress.com/wholesale?SearchText=M2x6+socket+head+screw | manufacturer_package | 2026-08-31 | Count bundled and owned stock then purchase only the shortage | Each XL330 package lists six M2x6 horn bolts; count included stock first
F003 | both | fasteners | M2 x 8 socket-head screws | M2 metric socket-head |  | 0 | 0 | 40 | piece | consumable | inferred | low | Confirm each stack with printed coupons and calipers | https://github.com/fanhao375/microduck-replica/blob/master/docs/%E7%B4%A7%E5%9B%BA%E4%BB%B6%E5%8F%8D%E6%8E%A8.md | Stock quantity includes loss and is not installed count | inventory_included_first | https://en.robotis.com/shop_en/item.php?it_id=902-0163-000 | https://www.aliexpress.com/wholesale?SearchText=M2x8+socket+head+screw | manufacturer_package | 2026-08-31 | Count bundled and owned stock then purchase only the shortage | Each XL330 package lists ten M2x8 frame bolts; count included stock first
F004 | both | fasteners | M2 x 12 socket-head screws | M2 metric socket-head |  | 0 | 0 | 15 | piece | consumable | inferred | low | Confirm each stack with printed coupons and calipers | https://github.com/fanhao375/microduck-replica/blob/master/docs/%E7%B4%A7%E5%9B%BA%E4%BB%B6%E5%8F%8D%E6%8E%A8.md | Stock quantity includes loss and is not installed count | verify_before_buy | https://www.aliexpress.com/wholesale?SearchText=M2x12+socket+head+screw |  | marketplace_search | 2026-08-31 | Complete the verification gate then order only the matching revision | Length is inferred from mesh depth and needs dry-fit confirmation
F005 | both | fasteners | M2 nuts | Metric nuts |  | 0 | 0 | 50 | piece | consumable | inferred | low | Confirm where through-bolting is physically possible | https://github.com/fanhao375/microduck-replica/blob/master/docs/%E7%B4%A7%E5%9B%BA%E4%BB%B6%E5%8F%8D%E6%8E%A8.md | Do not assume every hole accepts a nut | verify_before_buy | https://www.aliexpress.com/wholesale?SearchText=M2+hex+nut |  | marketplace_search | 2026-08-31 | Complete the verification gate then order only the matching revision | Confirm where through-bolting is accessible
F006 | both | fasteners | M2 heat-set inserts | For selected print material |  | 0 | 0 | 60 | piece | consumable | design_choice | medium | Pull-out and repeated-assembly coupon test |  | Preferred over directly tapping simulation-derived prints | verify_before_buy | https://www.aliexpress.com/wholesale?SearchText=M2+heat+set+insert |  | marketplace_search | 2026-08-31 | Complete the verification gate then order only the matching revision | Select insert OD and length only after coupon testing
F007 | both | fasteners | M2.5 x 6 screws | M2.5 metric |  | 0 | 0 | 20 | piece | consumable | inferred | low | Confirm all 2.7 to 2.8 mm holes before use | https://github.com/fanhao375/microduck-replica/blob/master/docs/%E7%B4%A7%E5%9B%BA%E4%BB%B6%E5%8F%8D%E6%8E%A8.md | Stock quantity only | verify_before_buy | https://www.aliexpress.com/wholesale?SearchText=M2.5x6+socket+head+screw |  | marketplace_search | 2026-08-31 | Complete the verification gate then order only the matching revision | Use only where measured holes confirm M2.5
F008 | both | fasteners | Servo horn fasteners | XL330-compatible horn and center screw |  | 15 | 15 | 18 | set | purchase | needs_confirmation | low | Confirm supplied hardware and spline engagement | https://emanual.robotis.com/docs/en/dxl/x/xl330-m288/ | May be included with each servo | inventory_included_first | https://en.robotis.com/shop_en/item.php?it_id=902-0163-000 |  | manufacturer_package | 2026-08-31 | Count bundled and owned stock then purchase only the shortage | Confirm horn hardware included with every servo before buying separately
F009 | roller | roller | Wheel axles | Diameter and retention TBD |  | 0 | 4 | 6 | piece | fabricate | needs_confirmation | low | Measure roller CAD and conduct pull-out test | https://github.com/fanhao375/microduck-replica | Not represented as a separate MJCF mesh | design_first |  |  | none | 2026-08-31 | Finish the dependent design and measurements before selecting a product | Axle diameter material and retention are not fixed
F010 | roller | roller | Wheel spacers and washers | Dimensions TBD |  | 0 | 0 |  | set | fabricate | needs_confirmation | low | Measure assembled wheel side play | https://github.com/fanhao375/microduck-replica | Quantity remains open | design_first |  |  | none | 2026-08-31 | Finish the dependent design and measurements before selecting a product | Spacer and washer stack depends on measured wheel side play
F011 | both | consumables | Low-strength threadlocker | Plastic-safe and removable |  | 0 | 0 | 1 | bottle | consumable | design_choice | medium | Compatibility test on printed polymer |  | Do not use on heat-set insert installation | ready_to_buy | https://next.henkel-adhesives.com/us/en/products/industrial-adhesives/central-pdp.html/loctite-222/BP000340.html |  | manufacturer_product | 2026-08-31 | Confirm regional stock and delivery then order the exact item | Use only after confirming compatibility with printed polymer and inserts
E001 | both | compute | Radxa Zero 3W | RK3566 with suitable RAM and storage |  | 1 | 1 | 1 | piece | purchase | confirmed_runtime | high | Boot current supported Armbian and expose ttyS2 | https://docs.radxa.com/en/zero/zero3 | Current alpha runtime target | ready_to_buy | https://radxa.com/products/zeros/zero3w/ | https://docs.radxa.com/en/zero/zero3 | manufacturer_buy | 2026-08-31 | Confirm regional stock and delivery then order the exact item | Choose Wi-Fi 3W not Ethernet-only 3E and confirm RAM storage and header option
E002 | both | compute | System storage | 32 GB or larger eMMC or microSD |  | 1 | 1 | 2 | piece | purchase | needs_confirmation | medium | Complete install update and rollback endurance test | https://docs.radxa.com/en/zero/zero3/download | One installed plus one recovery spare | verify_before_buy | https://www.sandisk.com/products/memory-cards/microsd-cards/sandisk-high-endurance-uhs-i-microsd?capacity=32GB | https://docs.radxa.com/en/zero/zero3/download | manufacturer_product | 2026-08-31 | Complete the verification gate then order only the matching revision | Use high-endurance storage only if the chosen Radxa SKU has no suitable eMMC
E003 | both | control | Replacement imu_to_dxl bench board v0.2 | Dynamixel V2 slave ID200 at 1 Mbps; 45 x 25 mm single-connector end node |  | 1 | 1 | 5 | piece | custom_board | design_choice | medium | Pass power bring-up register timing freshness and full-bus tests | https://github.com/pollen-robotics/microduck/blob/main/duck-control/src/imu.rs | Bench board order package only; final robot fit remains blocked on physical measurements | ready_to_buy | https://jlc.com/newOrder/#/pcb/pcbPlaceOrder |  | manufacturer_service | 2026-09-02 | Upload the frozen v0.2 Gerber BOM and CPL then review matched parts and production preview before payment | DRC and critical DFM red checks are clear; files and hashes are under docs/hardware/manufacturing
E004 | both | control | LSM6DSV16X IMU | ST 6-axis IMU with SFLP |  | 1 | 1 | 5 | piece | purchase | confirmed_runtime | high | Match gyro scale and quaternion output | https://github.com/pollen-robotics/microduck/blob/main/duck-control/src/imu.rs | One per assembled v0.2 board | ready_to_buy | https://www.lcsc.com/product-detail/C5267406.html | https://www.st.com/en/mems-and-sensors/lsm6dsv16x.html | authorized_distributor | 2026-09-02 | Confirm the exact C5267406 match and stock in the SMT component page | Exact LSM6DSV16XTR is frozen in the v0.2 BOM
E005 | both | control | IMU board MCU | STM32G030C8T6 LQFP48 using HSI16 and USART auto-baud |  | 1 | 1 | 5 | piece | purchase | design_choice | medium | Compile firmware then verify ABRF fail-closed behavior and measure 1 Mbps timing across voltage temperature plus SPI and SWD | https://www.st.com/resource/en/datasheet/stm32g030c6.pdf | One per assembled v0.2 board; PF0 PF1 are NC | ready_to_buy | https://www.lcsc.com/product-detail/C529329.html | https://www.st.com/en/microcontrollers-microprocessors/stm32g030c8.html | authorized_distributor | 2026-09-02 | Confirm the exact C529329 match and stock in the SMT component page | Exact STM32G030C8T6 is frozen in the v0.2 BOM
E006 | both | control | IMU board half-duplex interface | SN74LVC2G241DCTR complementary-enable TTL buffer |  | 1 | 1 | 5 | piece | purchase | design_choice | medium | Scope turnaround at 1 Mbps and validate collisions | https://emanual.robotis.com/docs/en/dxl/x/xl330-m288/#communication-circuit | One per assembled v0.2 board | ready_to_buy | https://www.lcsc.com/product-detail/C2676069.html | https://www.ti.com/lit/ds/symlink/sn74lvc2g241.pdf | authorized_distributor | 2026-09-02 | Confirm the exact C2676069 match and stock in the SMT component page | Exact SN74LVC2G241DCTR is frozen in the v0.2 BOM
E007 | both | control | IMU board PCB | Bench v0.2; 45 x 25 mm 2-layer FR-4 1.6 mm 1 oz |  | 1 | 1 | 5 | piece | fabricate | design_choice | medium | Verify frozen hashes production preview and bare-board continuity |  | Five boards cover bring-up destructive test comparison and two spares | ready_to_buy | https://jlc.com/newOrder/#/pcb/pcbPlaceOrder |  | manufacturer_service | 2026-09-02 | Upload docs/hardware/manufacturing/imu_to_dxl_v0_2_gerber.zip and stop before payment for final shipping review | Order checker accepted the file; not approved for robot installation and has no mounting holes
E008 | both | electronics | Replacement Robot HAT | 65 x 30 mm outline with power bus and peripherals |  | 1 | 1 | 3 | piece | custom_board | needs_confirmation | low | Electrical review and staged bring-up | https://github.com/pollen-robotics/microduck/tree/main/deploy/audio | Official schematic is not public | do_not_buy |  |  | none | 2026-08-31 | Do not order; replace with a designed or confirmed alternative | Official HAT is not sold; replacement design is required
E009 | both | electronics | 40-pin board header | Radxa Zero 3W compatible |  | 1 | 1 | 3 | piece | purchase | confirmed_runtime | medium | Mechanical stack-height and continuity test | https://docs.radxa.com/en/zero/zero3 | Two spares for board iterations | verify_before_buy | https://www.aliexpress.com/wholesale?SearchText=2x20+2.54mm+female+header | https://www.digikey.com/en/products/filter/headers-receptacles-female-sockets/315 | marketplace_search | 2026-08-31 | Complete the verification gate then order only the matching revision | Stack height and through-hole orientation must match the mechanical design
E010 | both | bus | Host half-duplex TTL interface | UART2 to single-wire 3.3 V TTL |  | 1 | 1 | 3 | piece | purchase | design_choice | low | Scope TX RX turnaround and full 16-device traffic | https://emanual.robotis.com/docs/en/dxl/x/xl330-m288/#communication-circuit | Must not require an unimplemented direction GPIO | design_first |  |  | none | 2026-08-31 | Finish the dependent design and measurements before selecting a product | Do not select a host interface until automatic turnaround is proven at 1 Mbps
E011 | both | power | Logic rail regulator | 2S input to regulated 5 V at least 3 A |  | 1 | 1 | 2 | piece | purchase | design_choice | medium | Load-step and thermal test with Radxa camera and sensors | https://docs.radxa.com/en/zero/zero3 | Final rating depends on measured load | design_first |  |  | none | 2026-08-31 | Finish the dependent design and measurements before selecting a product | Logic regulator selection depends on combined Radxa camera and sensor load test
E012 | both | power | Servo rail regulator | 2S input to adjustable output no greater than 6 V |  | 1 | 1 | 2 | piece | purchase | design_choice | low | Single-servo then five-servo transient and thermal tests | https://emanual.robotis.com/docs/en/dxl/x/xl330-m288/ | Current rating is blocked on measurements | design_first |  |  | none | 2026-08-31 | Finish the dependent design and measurements before selecting a product | Servo regulator current rating is blocked on one-servo and five-servo measurements
E013 | both | power | NP-F battery | NP-F550 or NP-F970 2S pack |  | 1 | 1 | 2 | piece | purchase | confirmed_runtime | medium | Mass clearance runtime and discharge test | https://github.com/pollen-robotics/microduck/blob/main/duck-control/src/model.rs | Use protected reputable packs | verify_before_buy | https://www.smallrig.com/global/SmallRig-NP-F970-Camera-Battery-4073.html | https://www.smallrig.com/NP-F970-USB-C-Rechargeable-Camera-Battery.html | manufacturer_shop | 2026-08-31 | Complete the verification gate then order only the matching revision | Confirm pack mass clearance protection behavior and selected NP-F size
E014 | both | power | NP-F battery plate | Matching pack contacts and mechanical retention |  | 1 | 1 | 2 | piece | purchase | needs_confirmation | low | Retention polarity and current test |  | Exact official part is unknown | verify_before_buy | https://www.aliexpress.com/wholesale?SearchText=NP-F970+battery+plate |  | marketplace_search | 2026-08-31 | Complete the verification gate then order only the matching revision | Confirm contact polarity retention and current rating
E015 | both | power | Main fuse | Replaceable fuse sized after load measurement |  | 1 | 1 | 5 | piece | purchase | design_choice | low | Fault injection and nuisance-trip test |  | Do not choose rating before current measurements | design_first |  |  | none | 2026-08-31 | Finish the dependent design and measurements before selecting a product | Fuse type and rating require measured normal and fault current
E016 | both | power | Master switch or emergency disconnect | DC-rated for measured current |  | 1 | 1 | 2 | piece | purchase | design_choice | medium | Interrupt worst-case load repeatedly |  | Must be reachable during suspended bring-up | design_first |  |  | none | 2026-08-31 | Finish the dependent design and measurements before selecting a product | Switch voltage current and breaking rating require measured load
E017 | both | power | Reverse-polarity and inrush protection | Low-loss protected input stage |  | 1 | 1 | 2 | piece | purchase | design_choice | low | Reverse input and hot-plug test with dummy load |  | Circuit remains to be designed | design_first |  |  | none | 2026-08-31 | Finish the dependent design and measurements before selecting a product | Protection topology must be designed and fault-tested
E018 | both | power | Bus bulk capacitance | Low-ESR capacitor bank sized from scope captures |  | 1 | 1 | 2 | set | purchase | design_choice | low | Keep bus within regulator limits during step load |  | Value remains open | design_first |  |  | none | 2026-08-31 | Finish the dependent design and measurements before selecting a product | Capacitance voltage rating and ESR depend on scope captures
E019 | both | vision | IMX219 camera module | Radxa-compatible Raspberry Pi Camera v2 class |  | 1 | 1 | 2 | piece | purchase | confirmed_runtime | medium | Verify 1080p30 capture orientation and thermal behavior | https://github.com/pollen-robotics/microduck/tree/main/mediad | One installed plus one spare | verify_before_buy | https://www.raspberrypi.com/products/camera-module-v2/ | https://www.seeedstudio.com/Raspberry-Pi-Camera-Module-V2.html | manufacturer_and_reseller | 2026-08-31 | Complete the verification gate then order only the matching revision | Confirm Radxa ribbon pinout and current runtime overlay before ordering
E020 | both | vision | MIPI CSI ribbon cable | Length and contact orientation TBD |  | 1 | 1 | 2 | piece | purchase | needs_confirmation | low | Verify routing through head and full motion |  | Length depends on final mechanical route | design_first |  |  | none | 2026-08-31 | Finish the dependent design and measurements before selecting a product | Ribbon contact orientation pitch and routed length are unresolved
E021 | both | ranging | VL53L8CX ToF module | 8 x 8 ranging module with I2C and Stemma/Qwiic |  | 1 | 1 | 2 | piece | purchase | confirmed_runtime | medium | Verify address 0x29 and stable 15 Hz stream | https://github.com/pollen-robotics/microduck/tree/main/tof | VL53L5CX compatibility requires separate validation | verify_before_buy | https://www.st.com/en/evaluation-tools/satel-vl53l8.html | https://estore.st.com/en/products/evaluation-tools-page61.html?marketing-status=Active&p=62 | manufacturer_buy | 2026-08-31 | Complete the verification gate then order only the matching revision | SATEL kit is for evaluation and may be too large; verify mechanical integration and driver compatibility
E022 | both | ranging | Stemma/Qwiic cable | Four-wire I2C cable length TBD |  | 1 | 1 | 2 | piece | purchase | needs_confirmation | low | Verify bend radius and head motion |  | Route before shell closure | design_first |  |  | none | 2026-08-31 | Finish the dependent design and measurements before selecting a product | Cable type and length depend on the selected ToF module
E023 | both | audio | Audio codec or replacement amplifier | Original TLV320AIC3104 path or simplified I2S output |  | 1 | 1 | 2 | piece | purchase | needs_confirmation | low | Playback capture noise and boot tests | https://github.com/pollen-robotics/microduck/tree/main/deploy/audio | Choose full codec only if microphone input is required | verify_before_buy | https://www.adafruit.com/product/3006 | https://github.com/pollen-robotics/microduck/tree/main/deploy/audio | manufacturer_shop | 2026-08-31 | Complete the verification gate then order only the matching revision | MAX98357A is only the output-only safe-replica option and does not provide microphone capture
E024 | both | audio | Microphone | Electrical and acoustic specification TBD |  | 1 | 1 | 2 | piece | purchase | needs_confirmation | low | Record speech and measure self-noise |  | Not represented by a distinct simulation mesh | design_first |  |  | none | 2026-08-31 | Finish the dependent design and measurements before selecting a product | Microphone electrical acoustic and connector requirements are unresolved
E025 | both | bus | Dynamixel cable segments | JST EH 3-pin with GND VDD DATA |  | 16 | 16 | 21 | piece | fabricate | inferred | low | Continuity polarity resistance and motion test | https://emanual.robotis.com/docs/en/dxl/x/xl330-m288/#connector-information | Length per segment remains to be measured | inventory_included_first | https://en.robotis.com/shop_en/item.php?it_id=902-0163-000 | https://www.digikey.com/en/product-highlight/j/jst/eh-series-connectors | manufacturer_package | 2026-08-31 | Count bundled and owned stock then purchase only the shortage | Each XL330 package includes one 180 mm X3P cable; measure routing before making custom lengths
E026 | both | bus | JST EHR-03 housings | Two per fabricated bus cable |  | 32 | 32 | 42 | piece | purchase | inferred | medium | Crimp pull test and keyed polarity check | https://emanual.robotis.com/docs/en/dxl/x/xl330-m288/#connector-information | Purchase quantity covers 21 cables | verify_before_buy | https://www.digikey.com/en/products/detail/jst-sales-america-inc/EHR-3/527225 |  | authorized_distributor | 2026-08-31 | Complete the verification gate then order only the matching revision | Buy only for custom cable lengths after the harness drawing is frozen
E027 | both | bus | JST SEH-001T-P0.6 terminals | Three per housing |  | 96 | 96 | 126 | piece | purchase | inferred | medium | Crimp cross-section or pull test | https://emanual.robotis.com/docs/en/dxl/x/xl330-m288/#connector-information | Purchase quantity covers 42 housings | verify_before_buy | https://www.digikey.com/en/products/detail/jst-sales-america-inc/SEH-001T-P0-6/26213194 | https://www.digikey.com/en/product-highlight/j/jst/eh-series-connectors | authorized_distributor | 2026-08-31 | Complete the verification gate then order only the matching revision | Verify wire gauge and crimp tooling before ordering production quantity
E028 | both | bus | Motor-bus wire | Red black and data conductors compatible with JST EH |  | 0 | 0 |  | meter | consumable | needs_confirmation | low | Measure total routed lengths plus service loops | https://emanual.robotis.com/docs/en/dxl/x/xl330-m288/#connector-information | Official manual lists 21 AWG but fit must be verified | design_first |  |  | none | 2026-08-31 | Finish the dependent design and measurements before selecting a product | Wire gauge insulation flexibility colors and total length remain open
E029 | both | service | USB-C service cable | Data-capable cable for flashing and recovery |  | 1 | 1 | 2 | piece | purchase | confirmed_runtime | high | Verify maskrom and normal data operation | https://docs.radxa.com/en/zero/zero3 | One spare recommended | choose_local |  |  | commodity | 2026-08-31 | Freeze acceptance criteria then choose a reputable local supplier | Choose a known data-capable USB-C cable and verify maskrom flashing
E030 | both | compute | Wi-Fi and Bluetooth antennas | Onboard or external depending Radxa SKU |  | 1 | 1 | 1 | set | purchase | needs_confirmation | medium | Range test with shells closed | https://docs.radxa.com/en/zero/zero3 | Confirm selected board SKU and antenna configuration | inventory_included_first | https://radxa.com/products/zeros/zero3w/ |  | manufacturer_product | 2026-08-31 | Count bundled and owned stock then purchase only the shortage | Zero 3W has onboard wireless; confirm selected antenna SKU before buying anything else
E031 | both | control | IMU board 3.3 V regulator | LP2985-33DBVR SOT23-5 |  | 1 | 1 | 5 | piece | purchase | design_choice | medium | Verify 3.7 to 6.0 V dropout thermal and transient behavior | https://www.ti.com/lit/ds/symlink/lp2985.pdf | One per assembled v0.2 board; active-high enable is tied to VIN per TI | ready_to_buy | https://www.lcsc.com/product-detail/C95414.html | https://www.ti.com/product/LP2985 | authorized_distributor | 2026-09-02 | Confirm the exact C95414 match and stock in the SMT component page | Exact LP2985-33DBVR is frozen in the v0.2 BOM
E032 | both | bus | IMU board JST EH PCB header | B3B-EH-A LF SN 3-pin 2.5 mm |  | 1 | 1 | 5 | piece | purchase | confirmed_runtime | medium | Verify pin order keying and PCB mechanical clearance | https://emanual.robotis.com/docs/en/dxl/x/xl330-m288/#connector-information | One J1 per v0.2 board; hand-solder after SMT | ready_to_buy | https://www.lcsc.com/product-detail/C160259.html | https://www.digikey.com/en/products/detail/jst-sales-america-inc/B3B-EH-A-LF-SN/926483 | authorized_distributor | 2026-09-02 | Confirm exact C160259 stock and that J1 remains SMD No in the placement preview | Exact B3B-EH-A LF SN is frozen in the v0.2 BOM and CPL as a through-hole row
E034 | both | service | IMU board SWD header | PZ127-2-05-S 2x5 1.27 mm SMT header |  | 1 | 1 | 5 | piece | purchase | design_choice | medium | Verify programmer pinout and cable clearance | https://www.lcsc.com/product-detail/C3975188.html | Exact JLC library device UUID 72524cb4eb6742dc93f30d3f1de759b8 | ready_to_buy | https://www.lcsc.com/product-detail/C3975188.html |  | authorized_distributor | 2026-09-02 | Confirm the exact C3975188 match and pin 1 orientation in the SMT preview | Critical solder-mask DFM red finding is cleared in v0.2
E035 | both | control | IMU board passive set | 0603 capacitors resistors and local bulk per board BOM |  | 1 | 1 | 5 | set | consumable | design_choice | medium | Check values voltage ratings placement and effective capacitance | https://github.com/pollen-robotics/microduck_rl | One complete passive set per assembled v0.2 board | ready_to_buy | https://www.lcsc.com/product-detail/C14663.html | https://www.lcsc.com/product-detail/C25804.html | authorized_distributor | 2026-09-02 | Confirm all exact LCSC groups in the SMT component page | Values quantities and JLC IDs are frozen in imu_to_dxl_v0_bom.csv
E036 | both | control | Future IMU-board data ESD protection | Low-capacitance 3.3 V-compatible clamp to be selected |  | 0 | 0 |  | piece | purchase | design_choice | low | Review leakage clamp and 1 Mbps waveform before a new PCB revision | https://www.nexperia.com/product/PESD3V3U1UL | Not present in v0.2 | design_first |  |  | none | 2026-09-02 | Select only after interface protection and scope review | Do not add a guessed substitute to the frozen v0.2 order
E037 | both | power | Future IMU-board rail transient protection | Clamp to be selected from measured hot-plug transients |  | 0 | 0 |  | piece | purchase | design_choice | low | Select from measured hot-plug transient and energy |  | Not present in v0.2 | design_first |  |  | none | 2026-09-02 | Measure the regulated servo rail before selecting a TVS | Do not add a guessed substitute to the frozen v0.2 order
C001 | both | materials | Rigid print material | PETG PA or equivalent after coupon tests |  | 0 | 0 | 1 | kilogram | consumable | design_choice | low | Strength creep impact and insert retention tests |  | Do not commit material before coupons | design_first |  |  | none | 2026-08-31 | Finish the dependent design and measurements before selecting a product | Select rigid material only after strength creep and insert coupons
C002 | both | materials | Flexible print material | TPU with selected shore hardness |  | 0 | 0 | 1 | spool | consumable | design_choice | low | Friction grip compression and tear tests |  | Used for mouth soles and roller tires | design_first |  |  | none | 2026-08-31 | Finish the dependent design and measurements before selecting a product | Select TPU shore hardness only after friction and tear coupons
C003 | both | materials | Prototype print material | Low-cost material for fit checks |  | 0 | 0 | 1 | spool | consumable | design_choice | medium | Dimension coupons and dry assemblies |  | Do not use for final load-bearing parts | choose_local |  |  | commodity | 2026-08-31 | Freeze acceptance criteria then choose a reputable local supplier | Any dimensionally stable low-cost filament is acceptable for fit prototypes
T001 | tooling | service | U2D2 or compatible Dynamixel adapter | USB to TTL Dynamixel interface |  | 0 | 0 | 1 | piece | tooling | design_choice | high | Configure one factory servo at a time | https://emanual.robotis.com/docs/en/dxl/x/xl330-m288/#quick-start | Required before multi-device bus assembly | ready_to_buy | https://www.robotis.us/u2d2/ | https://emanual.robotis.com/docs/en/parts/interface/u2d2/ | manufacturer_shop | 2026-08-31 | Confirm regional stock and delivery then order the exact item | Exact official adapter for single-servo ID and baud configuration
T002 | tooling | power | Current-limited bench supply | 0 to 6 V with logging preferred |  | 0 | 0 | 1 | piece | tooling | design_choice | high | Single-servo and subsystem current tests |  | Do not begin with an unrestricted battery | choose_local |  |  | tool_category | 2026-08-31 | Freeze acceptance criteria then choose a reputable local supplier | Choose a current-limited supply with logging after expected range is fixed
T003 | tooling | measurement | Digital multimeter | Continuity resistance and DC current capability |  | 0 | 0 | 1 | piece | tooling | design_choice | high | Independent polarity and continuity checks |  |  | choose_local |  |  | tool_category | 2026-08-31 | Freeze acceptance criteria then choose a reputable local supplier | Choose a reputable meter with continuity and protected current measurement
T004 | tooling | measurement | Oscilloscope | At least two channels and suitable bandwidth |  | 0 | 0 | 1 | piece | tooling | design_choice | medium | Inspect bus turnaround noise and power transients |  | Required for board validation | choose_local |  |  | tool_category | 2026-08-31 | Freeze acceptance criteria then choose a reputable local supplier | Choose at least two channels and enough bandwidth for 1 Mbps TTL edges
T005 | tooling | fabrication | JST EH crimp tool | Compatible with selected terminal and wire |  | 0 | 0 | 1 | piece | tooling | design_choice | medium | Repeatable pull-test results |  |  | verify_before_buy | https://media.digikey.com/pdf/Data%20Sheets/JST%20PDFs/Crimping_Tools_Machines.pdf |  | manufacturer_tooling_reference | 2026-08-31 | Complete the verification gate then order only the matching revision | JST lists YC-260R or equivalent tooling for SEH-001T-P0.6; verify source and cost
T006 | tooling | fabrication | Soldering and rework station | Temperature-controlled with hot-air access |  | 0 | 0 | 1 | set | tooling | design_choice | medium | Assemble and repair prototype boards |  |  | choose_local |  |  | tool_category | 2026-08-31 | Freeze acceptance criteria then choose a reputable local supplier | Choose temperature-controlled soldering and hot-air tools appropriate for the selected packages
T007 | tooling | measurement | Digital caliper | 0.01 mm display resolution |  | 0 | 0 | 1 | piece | tooling | design_choice | high | Measure bearing seats holes and fastener stacks |  |  | choose_local |  |  | tool_category | 2026-08-31 | Freeze acceptance criteria then choose a reputable local supplier | Choose a calibrated 0.01 mm display caliper from a reputable local supplier
T008 | tooling | safety | Suspended robot stand | Supports robot clear of floor with quick access |  | 0 | 0 | 1 | piece | tooling | design_choice | high | Stable through full joint travel |  | Required for first torque-on | design_first |  |  | none | 2026-08-31 | Finish the dependent design and measurements before selecting a product | Stand geometry depends on final robot mass envelope and emergency access
