qq2898498192-prog/codex/microduck_rl/src/mjlab_microduck/robot/microduck/assets/soft_mouth_top.stl

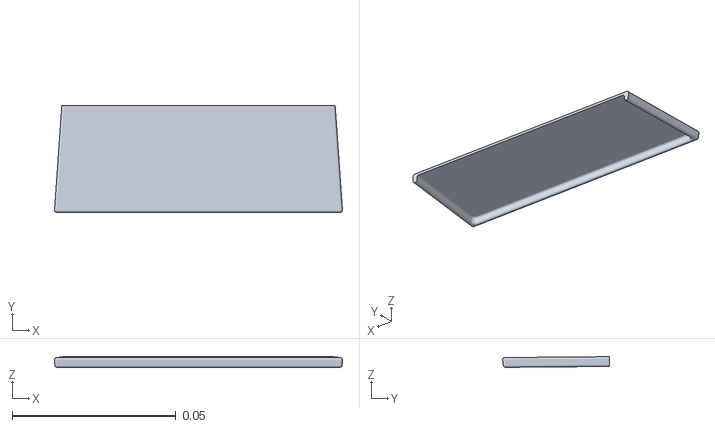
[picture p15: CAD file, 2026-09-07]
microduck_rl/src/mjlab_microduck/robot/microduck/assets/soft_mouth_top.stl
0.0878 x 0.0326 x 0.00328
