qq2898498192-prog/codex/microduck_rl/src/mjlab_microduck/robot/xl330_test_bench/assets/part_4.stl

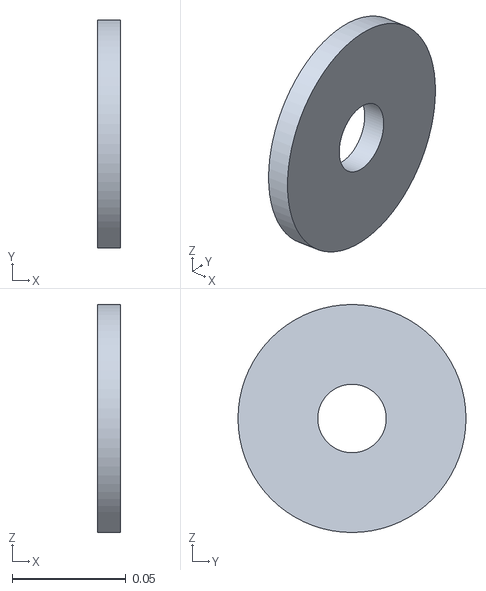
[picture p16: CAD file, 2026-09-07]
microduck_rl/src/mjlab_microduck/robot/xl330_test_bench/assets/part_4.stl
0.01 x 0.1 x 0.1
