qq2898498192-prog/codex/microduck_rl/src/mjlab_microduck/robot/xl330_test_bench/assets/part_5.stl

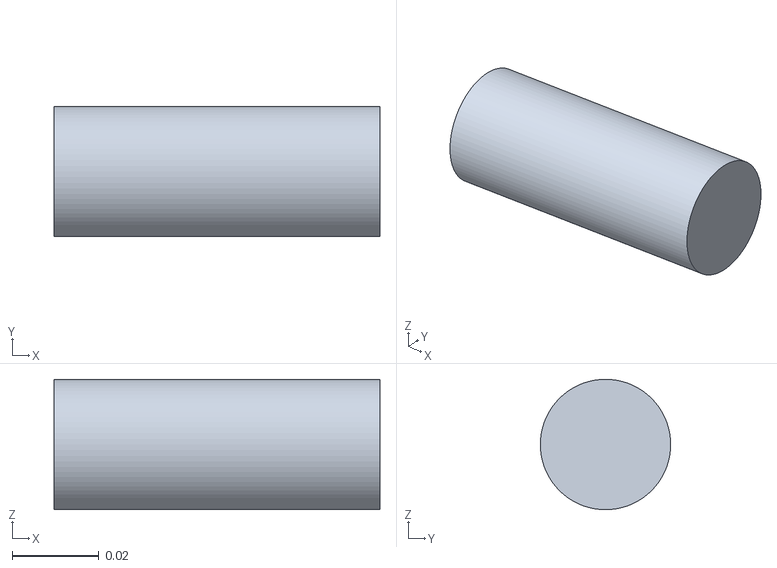
[picture p18: CAD file, 2026-09-07]
microduck_rl/src/mjlab_microduck/robot/xl330_test_bench/assets/part_5.stl
0.075 x 0.03 x 0.03
