qq2898498192-prog/codex/microduck_rl/src/mjlab_microduck/robot/microduck/assets/motor_support.stl

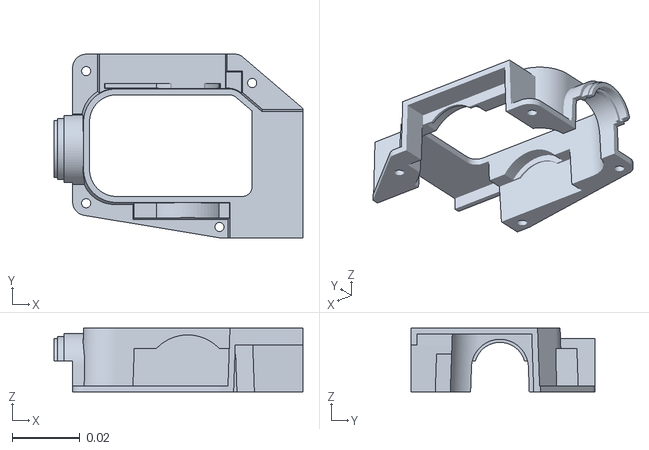
[picture p19: CAD file, 2026-09-07]
microduck_rl/src/mjlab_microduck/robot/microduck/assets/motor_support.stl
0.0735 x 0.0542 x 0.0188
