qq2898498192-prog/codex/microduck_rl/src/mjlab_microduck/robot/xl330_test_bench/assets/part_1.stl

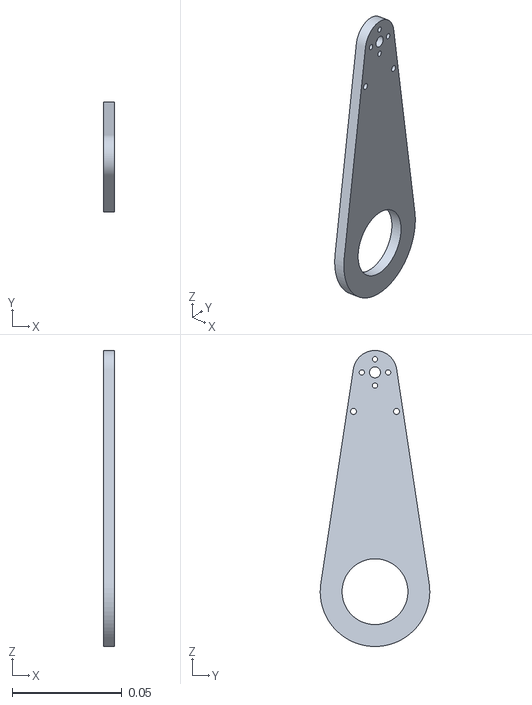
[picture p20: CAD file, 2026-09-07]
microduck_rl/src/mjlab_microduck/robot/xl330_test_bench/assets/part_1.stl
0.005 x 0.05 x 0.135
