qq2898498192-prog/codex/microduck_rl/src/mjlab_microduck/robot/microduck/assets/tire.stl

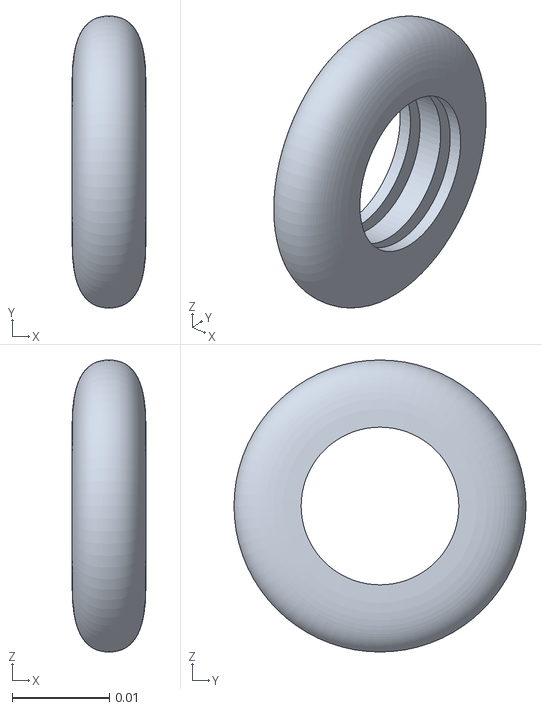
[picture p21: CAD file, 2026-09-07]
microduck_rl/src/mjlab_microduck/robot/microduck/assets/tire.stl
0.0076 x 0.03 x 0.03
