qq2898498192-prog/codex/microduck_rl/src/mjlab_microduck/robot/microduck/assets/right_upper_leg.stl

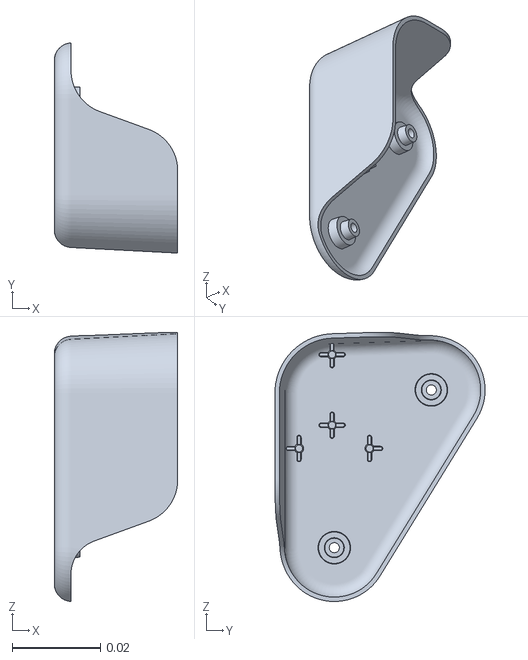
[picture p22: CAD file, 2026-09-07]
microduck_rl/src/mjlab_microduck/robot/microduck/assets/right_upper_leg.stl
0.028 x 0.0477 x 0.061
