qq2898498192-prog/codex/microduck_rl/src/mjlab_microduck/robot/xl330_test_bench/assets/spacer.stl

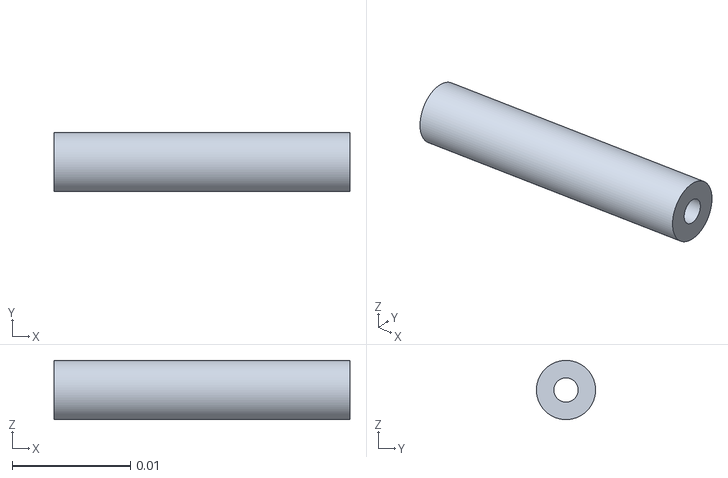
[picture p23: CAD file, 2026-09-07]
microduck_rl/src/mjlab_microduck/robot/xl330_test_bench/assets/spacer.stl
0.025 x 0.005 x 0.005
