qq2898498192-prog/codex/microduck_rl/src/mjlab_microduck/robot/microduck/assets/bottom_head_shell.stl

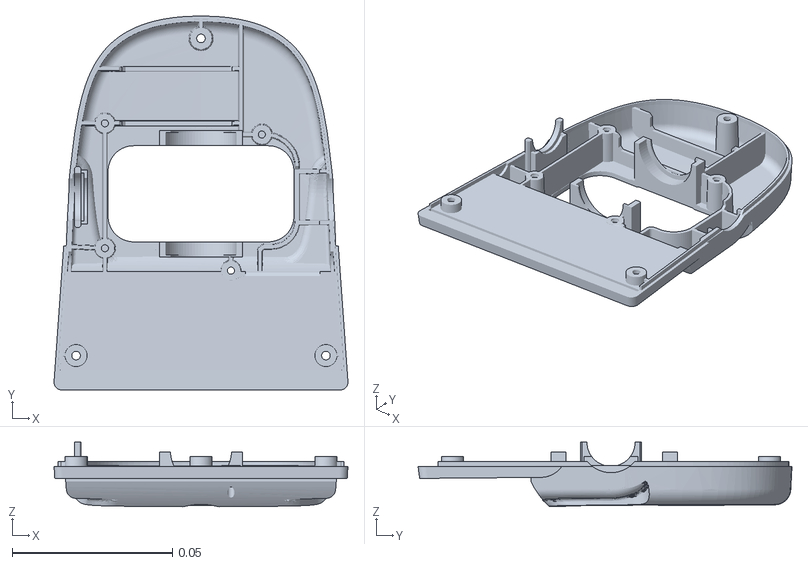
[picture p24: CAD file, 2026-09-07]
microduck_rl/src/mjlab_microduck/robot/microduck/assets/bottom_head_shell.stl
0.0918 x 0.117 x 0.0201
