qq2898498192-prog/codex/microduck_rl/src/mjlab_microduck/robot/microduck/assets/ankle_l_v1.stl

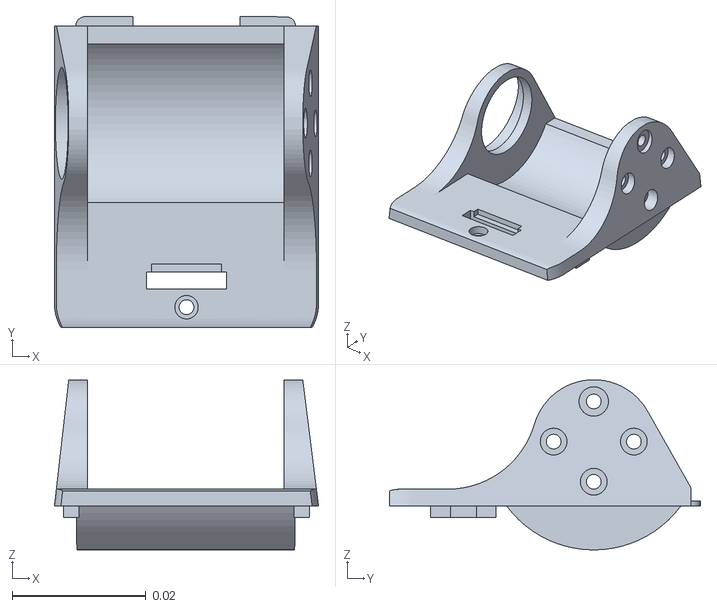
[picture p25: CAD file, 2026-09-07]
microduck_rl/src/mjlab_microduck/robot/microduck/assets/ankle_l_v1.stl
0.0395 x 0.0465 x 0.0254
