qq2898498192-prog/codex/microduck_rl/src/mjlab_microduck/robot/microduck/assets/ankle_right.stl

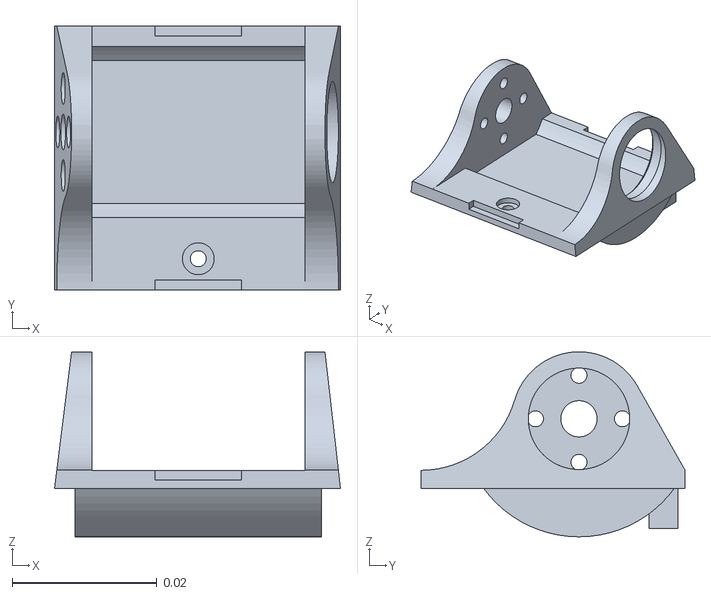
[picture p27: CAD file, 2026-09-07]
microduck_rl/src/mjlab_microduck/robot/microduck/assets/ankle_right.stl
0.0395 x 0.0365 x 0.0255
