qq2898498192-prog/codex/microduck_rl/src/mjlab_microduck/robot/microduck/assets/roller_blade.stl

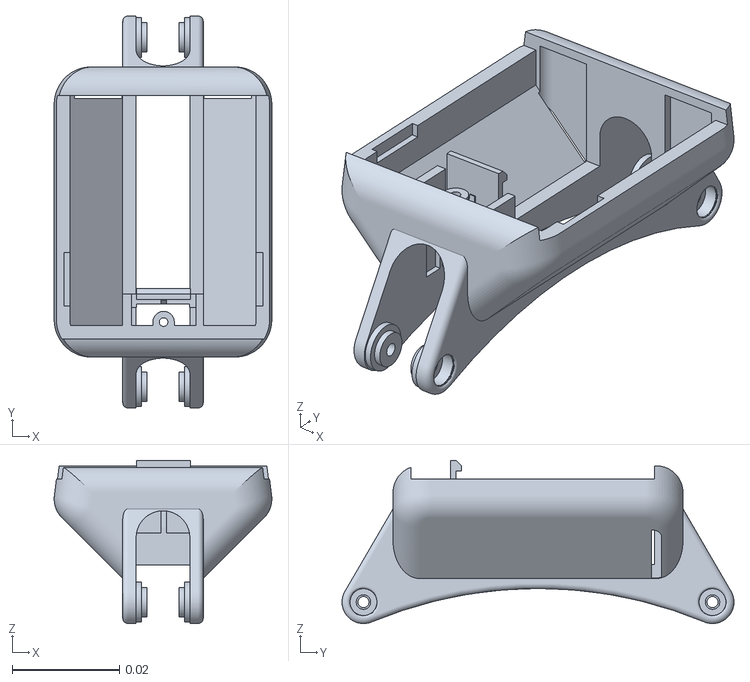
[picture p29: CAD file, 2026-09-07]
microduck_rl/src/mjlab_microduck/robot/microduck/assets/roller_blade.stl
0.0405 x 0.073 x 0.0304
