qq2898498192-prog/codex/microduck_rl/src/mjlab_microduck/robot/microduck/assets/lens.stl

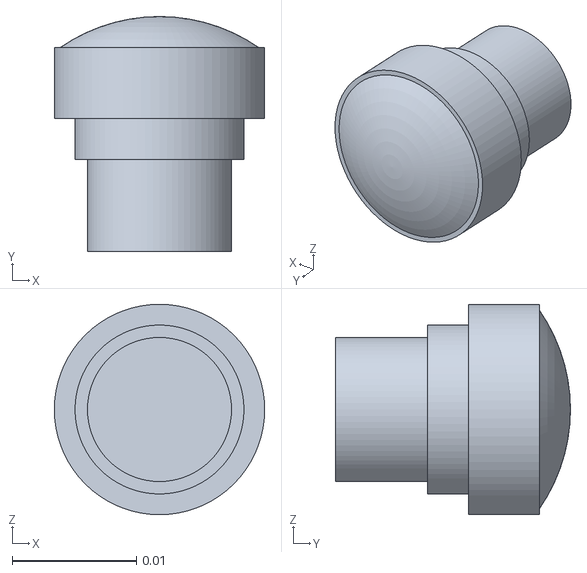
[picture p30: CAD file, 2026-09-07]
microduck_rl/src/mjlab_microduck/robot/microduck/assets/lens.stl
0.0169 x 0.0189 x 0.0169
