qq2898498192-prog/codex/microduck_rl/src/mjlab_microduck/robot/microduck/assets/jaw.stl

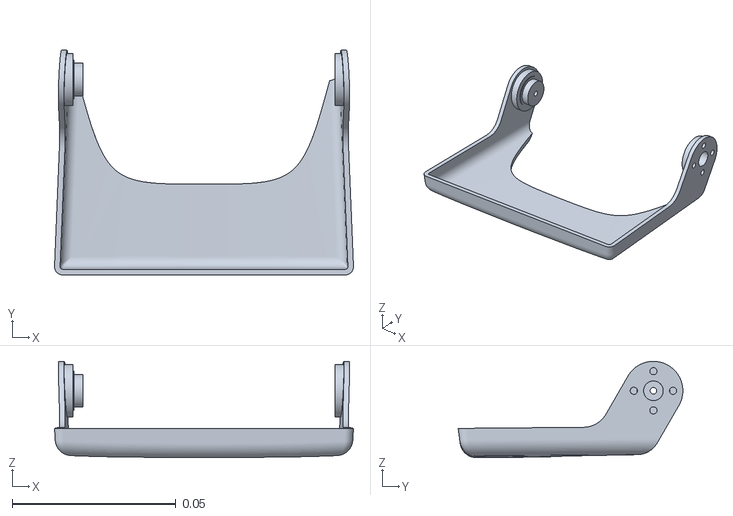
[picture p31: CAD file, 2026-09-07]
microduck_rl/src/mjlab_microduck/robot/microduck/assets/jaw.stl
0.0914 x 0.0687 x 0.0294
