qq2898498192-prog/codex/microduck_rl/src/mjlab_microduck/robot/microduck/assets/foot_left.stl

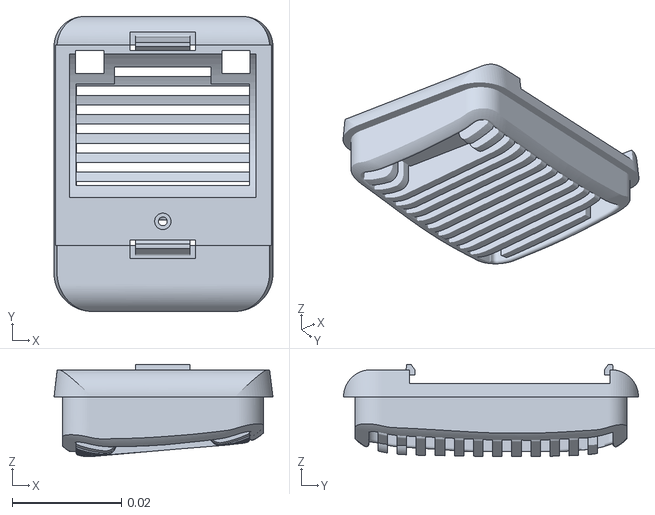
[picture p32: CAD file, 2026-09-07]
microduck_rl/src/mjlab_microduck/robot/microduck/assets/foot_left.stl
0.0401 x 0.054 x 0.0169
