qq2898498192-prog/codex/microduck_rl/src/mjlab_microduck/robot/microduck/assets/sole_left.stl

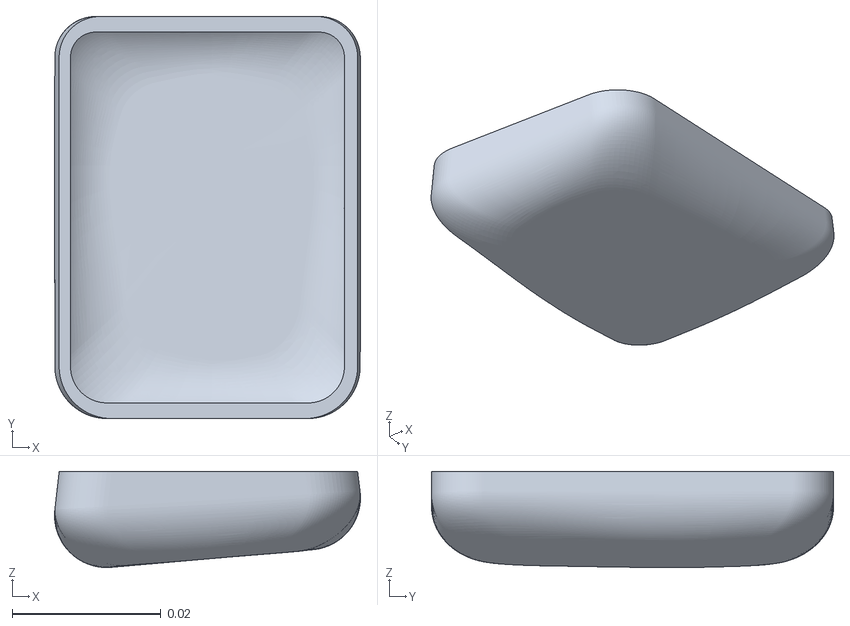
[picture p33: CAD file, 2026-09-07]
microduck_rl/src/mjlab_microduck/robot/microduck/assets/sole_left.stl
0.0411 x 0.054 x 0.0129
