qq2898498192-prog/codex/microduck_rl/src/mjlab_microduck/robot/microduck/assets/upper_leg_rigidity_plate.stl

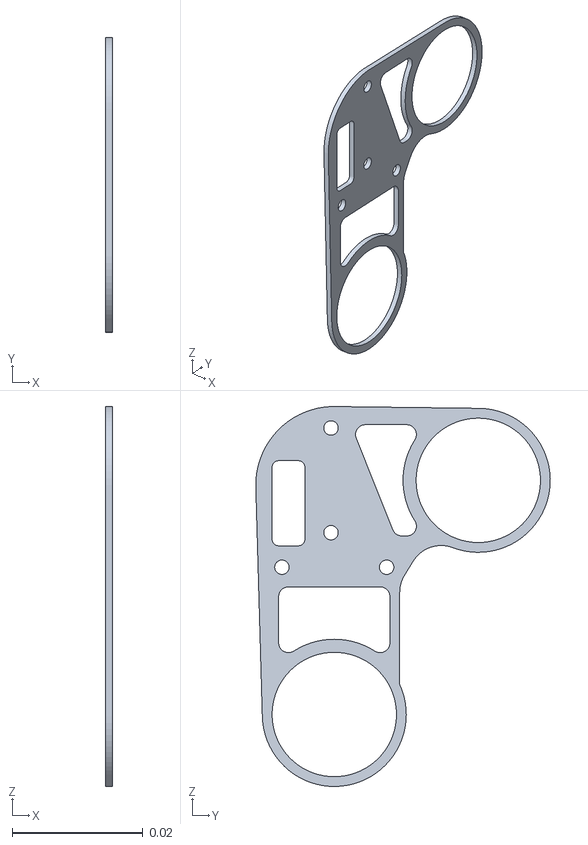
[picture p34: CAD file, 2026-09-07]
microduck_rl/src/mjlab_microduck/robot/microduck/assets/upper_leg_rigidity_plate.stl
0.001 x 0.045 x 0.0581
