qq2898498192-prog/codex/microduck_rl/src/mjlab_microduck/robot/microduck/assets/seeed_bearing__configuration__22x16x4.stl

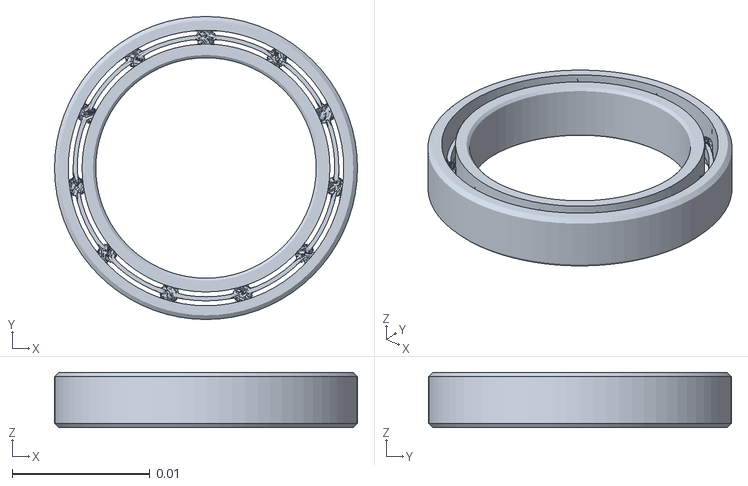
[picture p35: CAD file, 2026-09-07]
microduck_rl/src/mjlab_microduck/robot/microduck/assets/seeed_bearing__configuration__22x16x4.stl
0.022 x 0.022 x 0.004
