qq2898498192-prog/codex/microduck_rl/src/mjlab_microduck/robot/microduck/assets/yaw2roll.stl

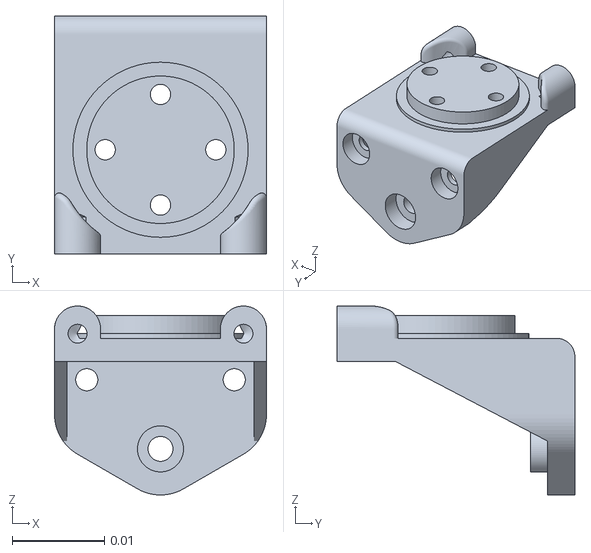
[picture p36: CAD file, 2026-09-07]
microduck_rl/src/mjlab_microduck/robot/microduck/assets/yaw2roll.stl
0.023 x 0.0258 x 0.0205
