qq2898498192-prog/codex/microduck_rl/src/mjlab_microduck/robot/microduck/assets/leg.stl

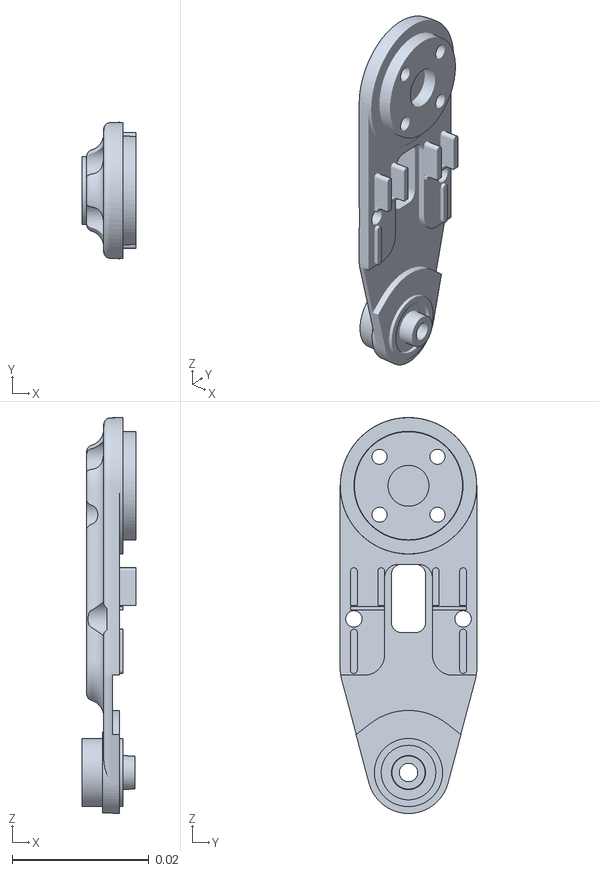
[picture p37: CAD file, 2026-09-07]
microduck_rl/src/mjlab_microduck/robot/microduck/assets/leg.stl
0.00795 x 0.02 x 0.058
