qq2898498192-prog/codex/microduck_rl/src/mjlab_microduck/robot/microduck/assets/bearing_roll.stl

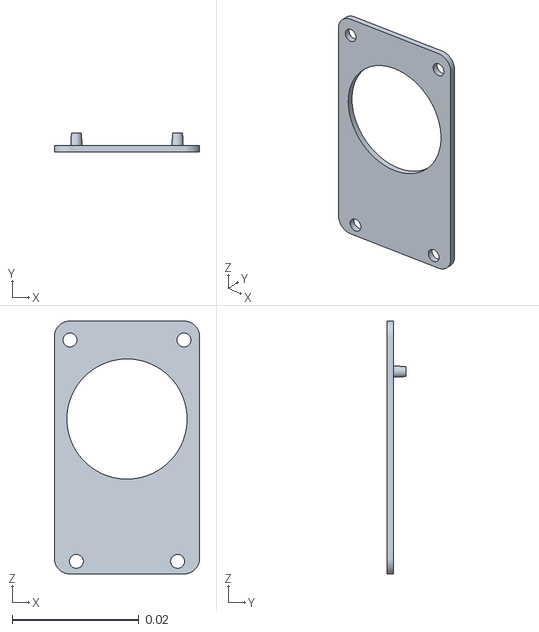
[picture p38: CAD file, 2026-09-07]
microduck_rl/src/mjlab_microduck/robot/microduck/assets/bearing_roll.stl
0.023 x 0.003 x 0.04
