qq2898498192-prog/codex/microduck_rl/src/mjlab_microduck/robot/microduck/assets/trunk_shell_left.stl

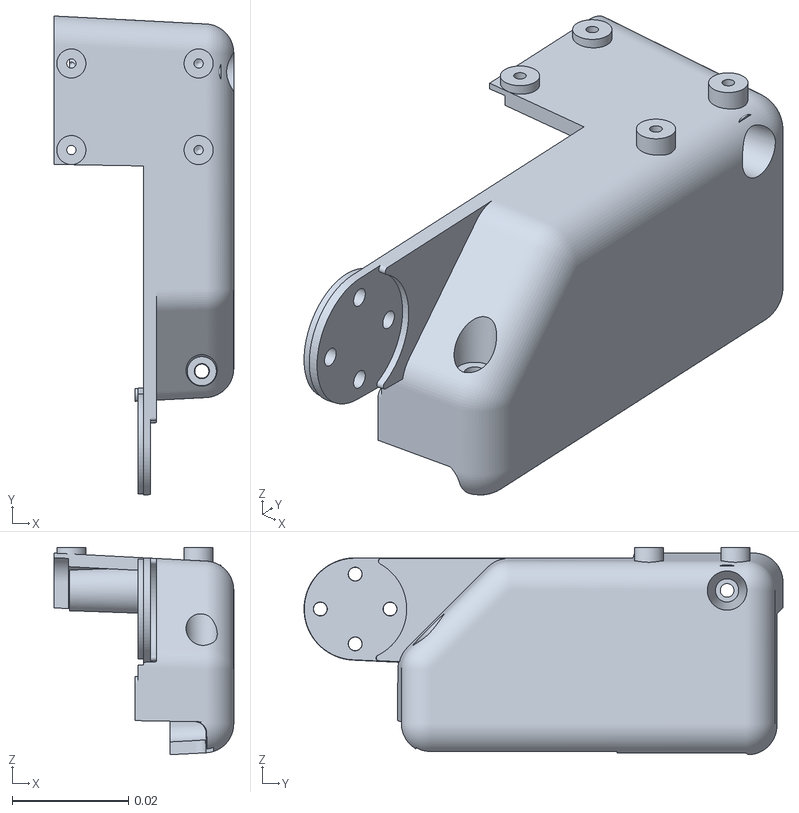
[picture p39: CAD file, 2026-09-07]
microduck_rl/src/mjlab_microduck/robot/microduck/assets/trunk_shell_left.stl
0.0309 x 0.0824 x 0.0357
