qq2898498192-prog/codex/microduck_rl/src/mjlab_microduck/robot/microduck/assets/power_support.stl

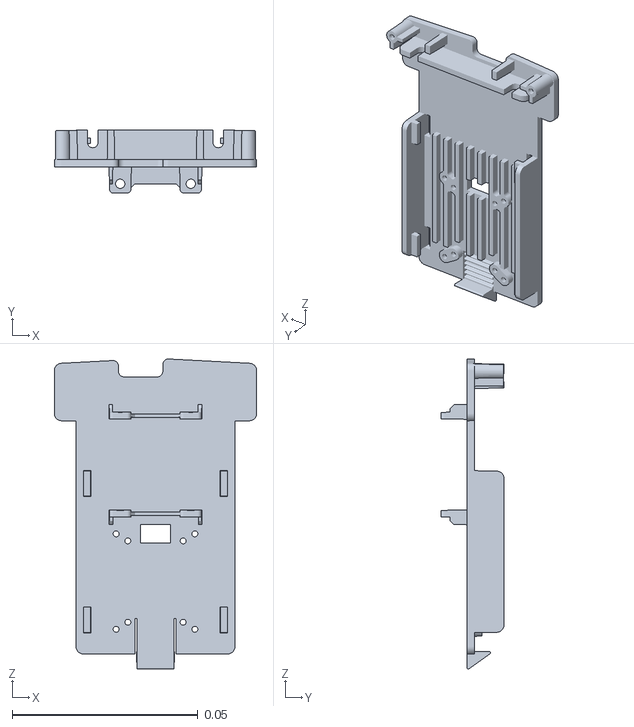
[picture p42: CAD file, 2026-09-07]
microduck_rl/src/mjlab_microduck/robot/microduck/assets/power_support.stl
0.0545 x 0.017 x 0.0835
