qq2898498192-prog/codex/microduck_rl/src/mjlab_microduck/robot/microduck/assets/rim.stl

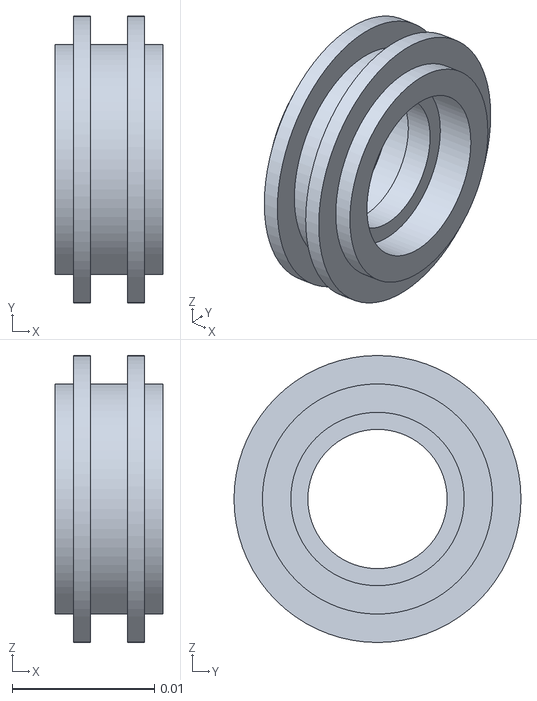
[picture p43: CAD file, 2026-09-07]
microduck_rl/src/mjlab_microduck/robot/microduck/assets/rim.stl
0.0076 x 0.0202 x 0.0202
