qq2898498192-prog/codex/microduck_rl/src/mjlab_microduck/robot/microduck/assets/seeed_bearing__configuration_default.stl

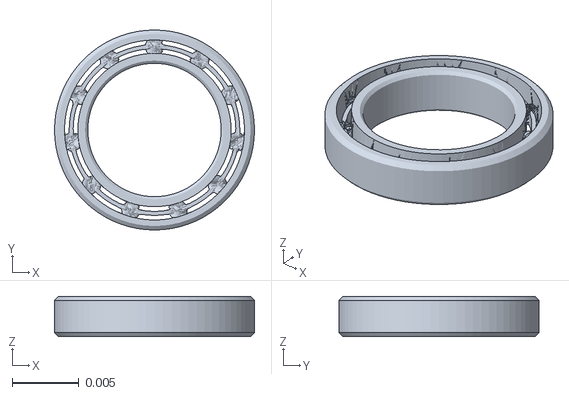
[picture p44: CAD file, 2026-09-07]
microduck_rl/src/mjlab_microduck/robot/microduck/assets/seeed_bearing__configuration_default.stl
0.015 x 0.015 x 0.003
