qq2898498192-prog/codex/microduck_rl/src/mjlab_microduck/robot/microduck/assets/trunk_base.stl

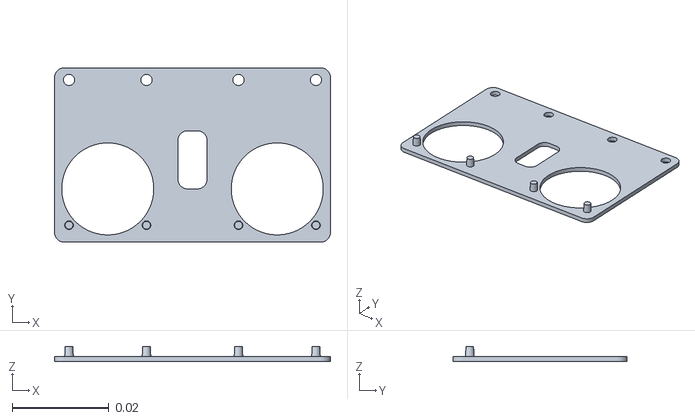
[picture p45: CAD file, 2026-09-07]
microduck_rl/src/mjlab_microduck/robot/microduck/assets/trunk_base.stl
0.057 x 0.036 x 0.003
