qq2898498192-prog/codex/microduck_rl/src/mjlab_microduck/robot/microduck/assets/yaw_roll_motion.stl

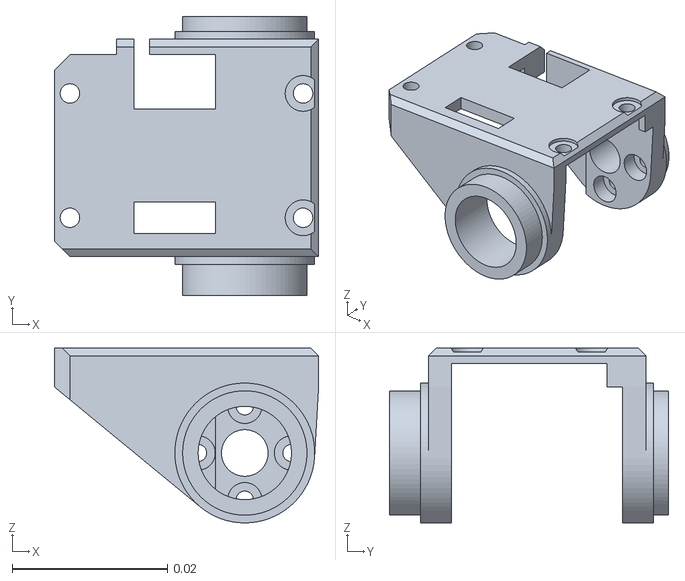
[picture p46: CAD file, 2026-09-07]
microduck_rl/src/mjlab_microduck/robot/microduck/assets/yaw_roll_motion.stl
0.034 x 0.0359 x 0.0225
