qq2898498192-prog/codex/microduck_rl/src/mjlab_microduck/robot/microduck/assets/np_f970.stl

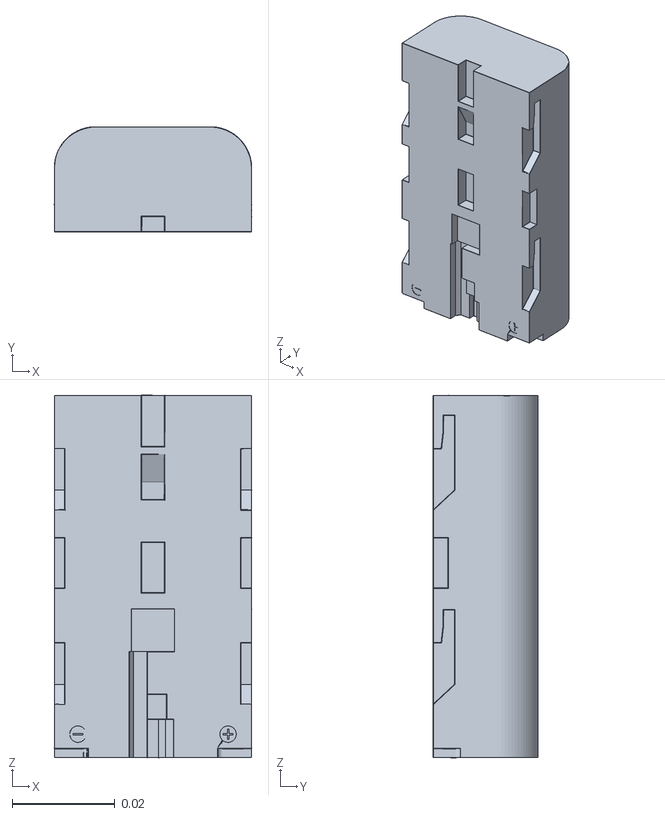
[picture p47: CAD file, 2026-09-07]
microduck_rl/src/mjlab_microduck/robot/microduck/assets/np_f970.stl
0.0386 x 0.0206 x 0.0708
