qq2898498192-prog/codex/microduck_rl/src/mjlab_microduck/robot/microduck/assets/right_shell.stl

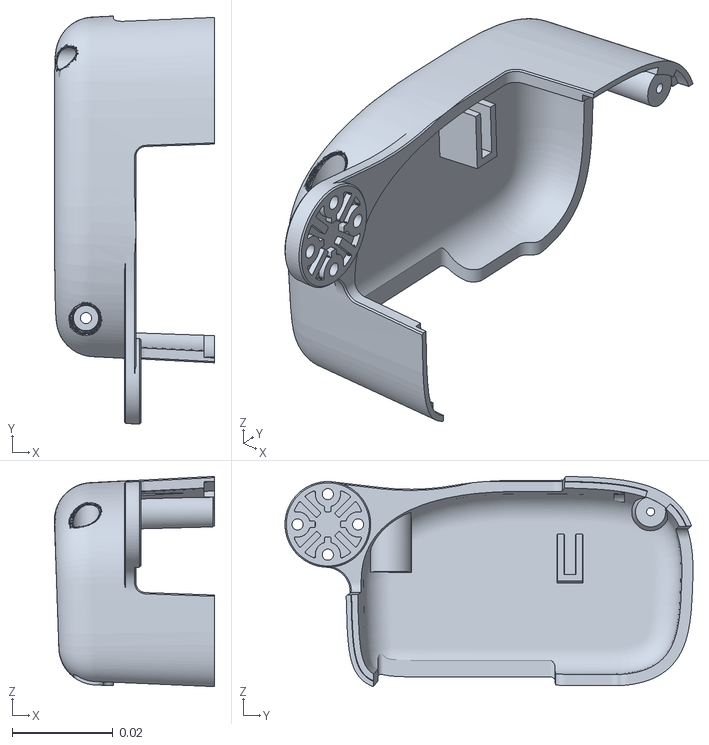
[picture p48: CAD file, 2026-09-07]
microduck_rl/src/mjlab_microduck/robot/microduck/assets/right_shell.stl
0.0318 x 0.0809 x 0.0417
