qq2898498192-prog/codex/microduck_rl/src/mjlab_microduck/robot/microduck/assets/pcb__raspberry_pi_zero_2_w.stl

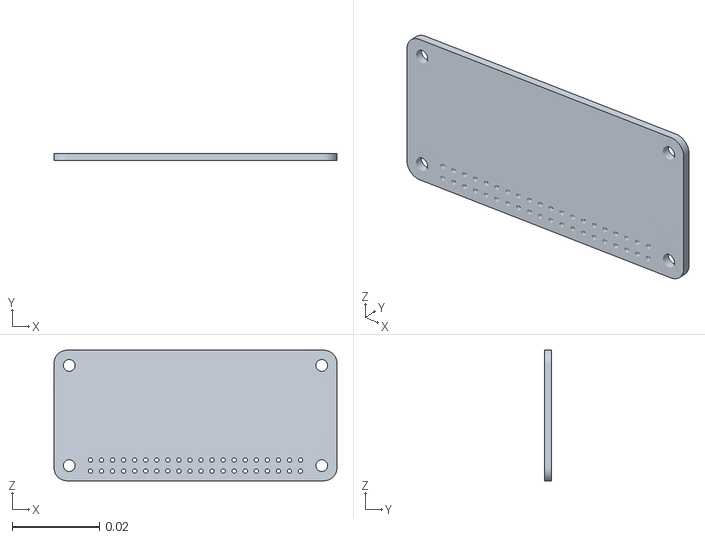
[picture p49: CAD file, 2026-09-07]
microduck_rl/src/mjlab_microduck/robot/microduck/assets/pcb__raspberry_pi_zero_2_w.stl
0.065 x 0.0016 x 0.03
