qq2898498192-prog/codex/microduck_rl/src/mjlab_microduck/robot/microduck/assets/m12_lens_holder.stl

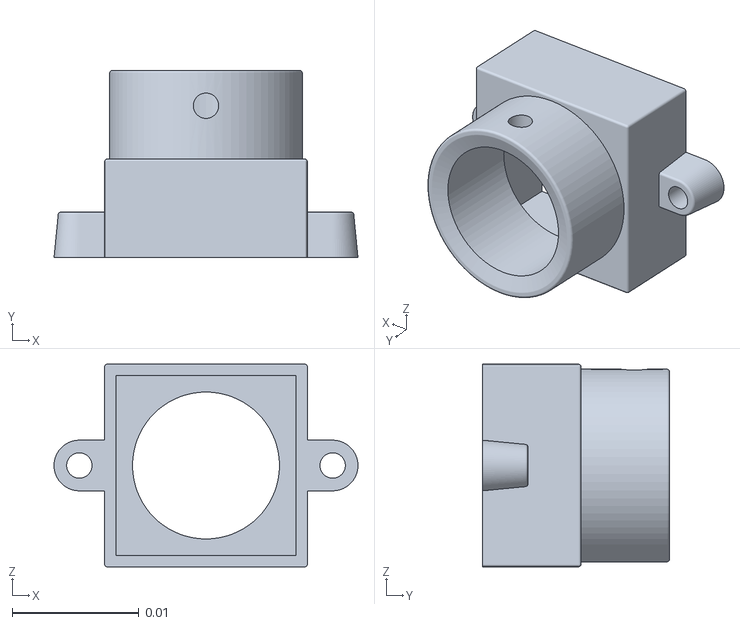
[picture p50: CAD file, 2026-09-07]
microduck_rl/src/mjlab_microduck/robot/microduck/assets/m12_lens_holder.stl
0.024 x 0.0148 x 0.016
