qq2898498192-prog/codex/microduck_rl/src/mjlab_microduck/robot/microduck/assets/jaw_soft.stl

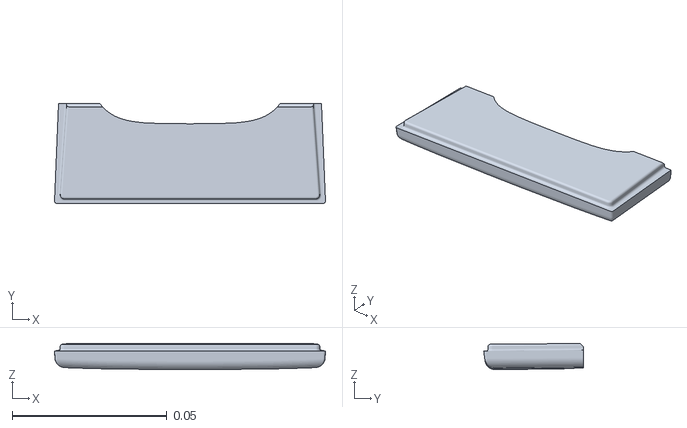
[picture p51: CAD file, 2026-09-07]
microduck_rl/src/mjlab_microduck/robot/microduck/assets/jaw_soft.stl
0.0877 x 0.0322 x 0.00844
