qq2898498192-prog/codex/microduck_rl/src/mjlab_microduck/robot/microduck/assets/face_part.stl

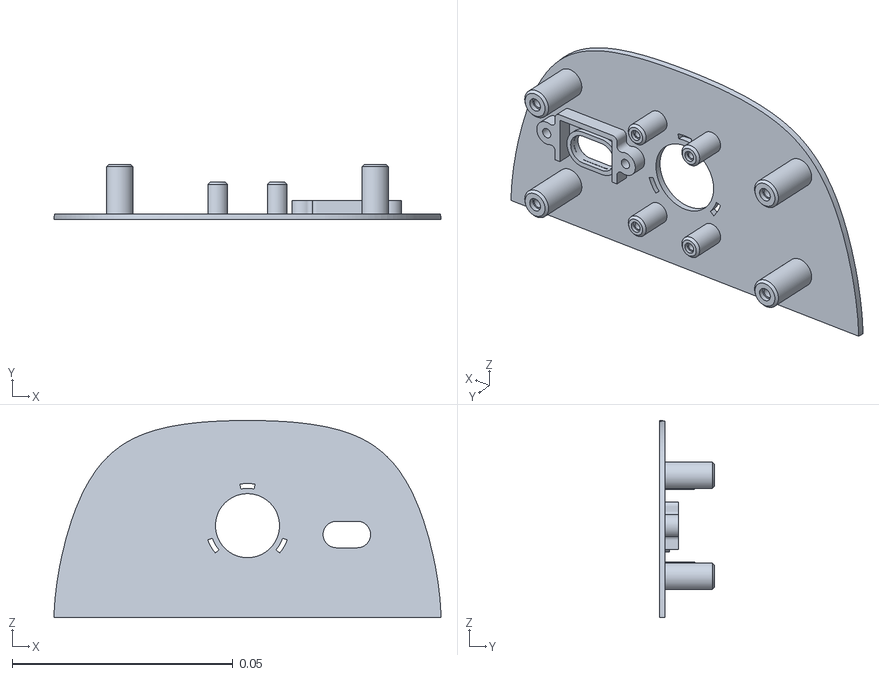
[picture p52: CAD file, 2026-09-07]
microduck_rl/src/mjlab_microduck/robot/microduck/assets/face_part.stl
0.0877 x 0.0125 x 0.0446
