qq2898498192-prog/codex/microduck_rl/src/mjlab_microduck/robot/microduck/assets/neck_pitch.stl

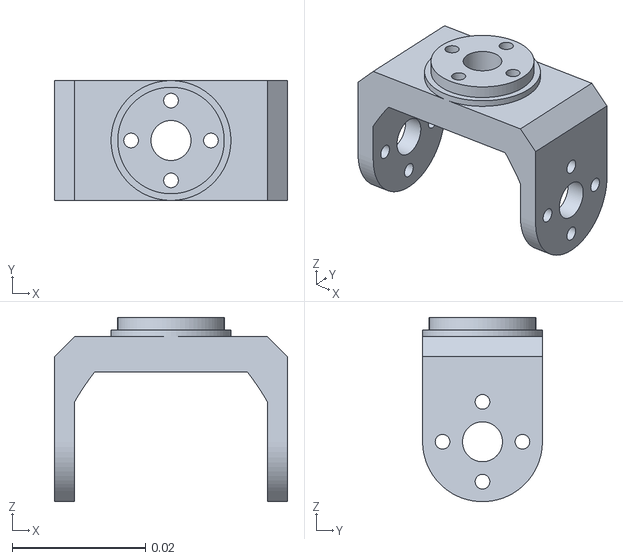
[picture p53: CAD file, 2026-09-07]
microduck_rl/src/mjlab_microduck/robot/microduck/assets/neck_pitch.stl
0.035 x 0.018 x 0.0277
