qq2898498192-prog/codex/microduck_rl/src/mjlab_microduck/robot/microduck/assets/noenoeil.stl

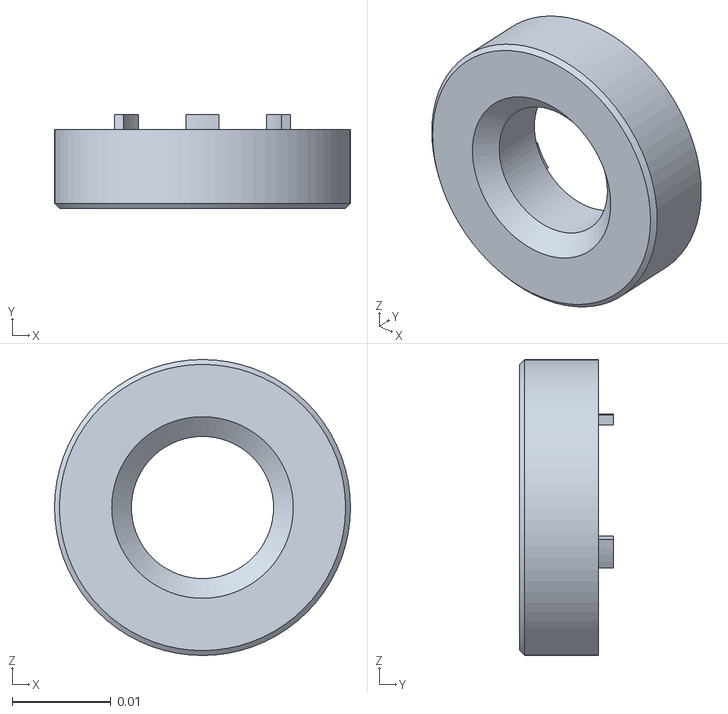
[picture p55: CAD file, 2026-09-07]
microduck_rl/src/mjlab_microduck/robot/microduck/assets/noenoeil.stl
0.03 x 0.0095 x 0.03
