qq2898498192-prog/codex/microduck_rl/src/mjlab_microduck/robot/microduck/assets/hip_l.stl

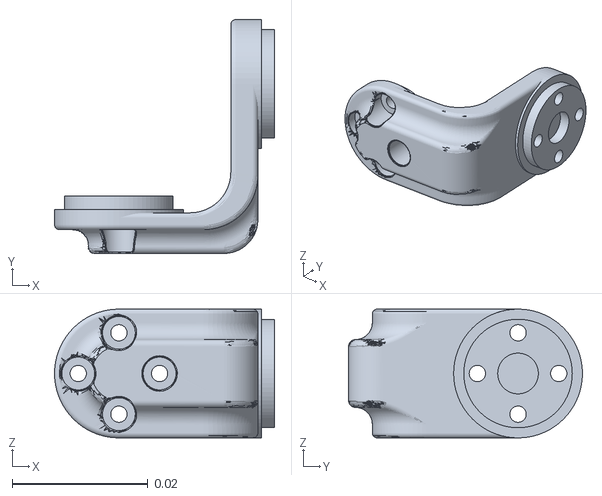
[picture p56: CAD file, 2026-09-07]
microduck_rl/src/mjlab_microduck/robot/microduck/assets/hip_l.stl
0.0325 x 0.0345 x 0.019
