qq2898498192-prog/codex/microduck_rl/src/mjlab_microduck/robot/microduck/assets/speaker.stl

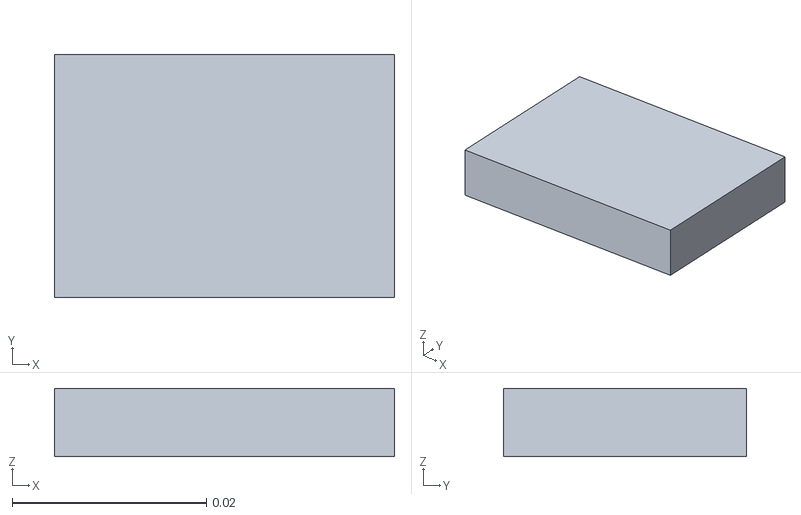
[picture p57: CAD file, 2026-09-07]
microduck_rl/src/mjlab_microduck/robot/microduck/assets/speaker.stl
0.035 x 0.025 x 0.007
