qq2898498192-prog/codex/microduck_rl/src/mjlab_microduck/robot/microduck/assets/elec_rpi_robot_hat_pcb.stl

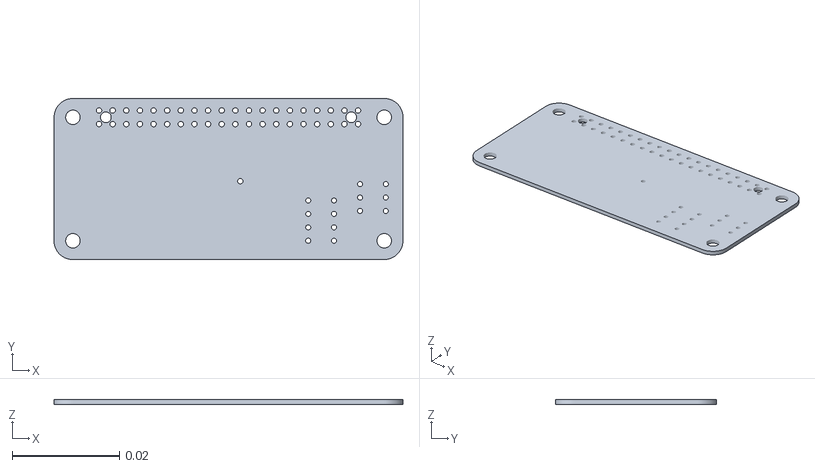
[picture p58: CAD file, 2026-09-07]
microduck_rl/src/mjlab_microduck/robot/microduck/assets/elec_rpi_robot_hat_pcb.stl
0.065 x 0.03 x 0.00084
