qq2898498192-prog/codex/microduck_rl/src/mjlab_microduck/robot/microduck/assets/neck.stl

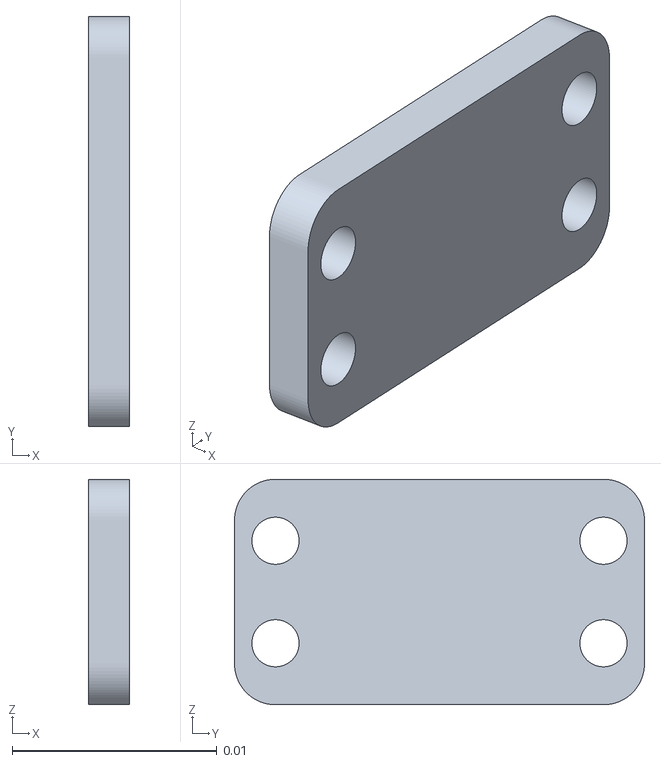
[picture p59: CAD file, 2026-09-07]
microduck_rl/src/mjlab_microduck/robot/microduck/assets/neck.stl
0.002 x 0.02 x 0.011
