qq2898498192-prog/codex/projects/microduck-pet-v2/layout/layout_envelopes.scad

// mm. Space envelopes only; not printable production parts.
explode=0;
show_shell=false;
// H01 一体头壳 / 无嘴 暂定
if(show_shell) color([0.7450980392156863, 0.803921568627451, 0.8274509803921568],0.5) translate([0, 0, 327]) cube([110, 86, 92],center=true);
// H02 2.8英寸屏幕整板 混合
color([0.2235294117647059, 0.6509803921568628, 0.6666666666666666],0.5) translate([0, -32, 315]) cube([79.9, 15, 50.8],center=true);
// H03 IMX219摄像头 混合
color([0.2235294117647059, 0.6509803921568628, 0.6666666666666666],0.5) translate([0, -30, 355]) cube([25, 12, 24],center=true);
// H04 VL53L5CX载板 混合
color([0.2235294117647059, 0.6509803921568628, 0.6666666666666666],0.5) translate([32, -30, 355]) cube([12.7, 10, 17.78],center=true);
// H05 头内模组托架 暂定
color([0.38823529411764707, 0.4666666666666667, 0.5019607843137255],0.5) translate([0, 0, 331]) cube([94, 4, 74],center=true);
// Y01 头转台承重轴承 暂定
color([0.5882352941176471, 0.3568627450980392, 0.6784313725490196],0.5) translate([0, 0, 279]) cube([42, 42, 10],center=true);
// Y02 转台轮毂 / 限位 暂定
color([0.5882352941176471, 0.3568627450980392, 0.6784313725490196],0.5) translate([0, 0, 267]) cube([38, 38, 10],center=true);
// Y03 转向执行器 未选型
color([0.5882352941176471, 0.3568627450980392, 0.6784313725490196],0.5) translate([0, 0, 244]) cube([40, 32, 30],center=true);
// Y04 竖直承力颈座 暂定
if(show_shell) color([0.7450980392156863, 0.803921568627451, 0.8274509803921568],0.5) translate([0, 0, 248]) cube([56, 56, 55],center=true);
// B01 躯干后盖 暂定
if(show_shell) color([0.7450980392156863, 0.803921568627451, 0.8274509803921568],0.5) translate([0, 48, 193]) cube([164, 4, 72],center=true);
// B02 ZERO 3W主控 混合
color([0.16470588235294117, 0.611764705882353, 0.45098039215686275],0.5) translate([0, 20, 214]) cube([65, 30, 14],center=true);
// B03 主控散热器预留 暂定
color([0.5529411764705883, 0.5882352941176471, 0.611764705882353],0.5) translate([0, 20, 228]) cube([55, 25, 10],center=true);
// B04 电源及实时控制板 未设计
color([0.16470588235294117, 0.611764705882353, 0.45098039215686275],0.5) translate([0, -22, 214]) cube([75, 40, 14],center=true);
// B05 3S电池组含BMS 未选型
color([0.8705882352941177, 0.6862745098039216, 0.3137254901960784],0.5) translate([0, 0, 177]) cube([75, 58, 24],center=true);
// B06 电池托盘 暂定
color([0.38823529411764707, 0.4666666666666667, 0.5019607843137255],0.5) translate([0, 0, 162]) cube([82, 65, 4],center=true);
// B07 充电口/总开关 未选型
color([0.16470588235294117, 0.611764705882353, 0.45098039215686275],0.5) translate([66, 0, 183]) cube([20, 30, 24],center=true);
// B08 躯干外壳 暂定
if(show_shell) color([0.7450980392156863, 0.803921568627451, 0.8274509803921568],0.5) translate([0, 0, 196]) cube([164, 100, 78],center=true);
// L01 左承力腿 暂定
color([0.38823529411764707, 0.4666666666666667, 0.5019607843137255],0.5) translate([-69, 0, 122]) cube([28, 38, 65],center=true);
// L02 右承力腿 暂定
color([0.38823529411764707, 0.4666666666666667, 0.5019607843137255],0.5) translate([69, 0, 122]) cube([28, 38, 65],center=true);
// L03 横向承力连接 暂定
color([0.38823529411764707, 0.4666666666666667, 0.5019607843137255],0.5) translate([0, 12, 131]) cube([110, 14, 16],center=true);
// L01 L脚部检修盖 暂定
if(show_shell) color([0.7450980392156863, 0.803921568627451, 0.8274509803921568],0.5) translate([-69, 0, 88]) cube([84, 150, 4],center=true);
// L02 L双路轮驱动板 未设计
color([0.16470588235294117, 0.611764705882353, 0.45098039215686275],0.5) translate([-69, 0, 69]) cube([64, 54, 16],center=true);
// L03 L电机承力托架 暂定
if(show_shell) color([0.7450980392156863, 0.803921568627451, 0.8274509803921568],0.5) translate([-69, 0, 46]) cube([84, 150, 67],center=true);
// LFM LF轮电机 #4846 已知外包络
color([0.3254901960784314, 0.6, 0.7725490196078432],0.5) translate([-69, -48, 30]) cube([69, 25, 25],center=true);
// LFC LF输出轴/联轴器 暂定
color([0.4627450980392157, 0.5058823529411764, 0.5568627450980392],0.5) translate([-110, -48, 30]) cube([13, 16, 16],center=true);
// LFA LF承重轴承座 暂定
color([0.4627450980392157, 0.5058823529411764, 0.5568627450980392],0.5) translate([-119, -48, 30]) cube([5, 24, 24],center=true);
// LFW LF麦克纳姆轮 未选型
color([0.9294117647058824, 0.596078431372549, 0.1843137254901961],0.5) translate([-132, -48, 30]) cube([30, 60, 60],center=true);
// LBM LB轮电机 #4846 已知外包络
color([0.3254901960784314, 0.6, 0.7725490196078432],0.5) translate([-69, 48, 30]) cube([69, 25, 25],center=true);
// LBC LB输出轴/联轴器 暂定
color([0.4627450980392157, 0.5058823529411764, 0.5568627450980392],0.5) translate([-110, 48, 30]) cube([13, 16, 16],center=true);
// LBA LB承重轴承座 暂定
color([0.4627450980392157, 0.5058823529411764, 0.5568627450980392],0.5) translate([-119, 48, 30]) cube([5, 24, 24],center=true);
// LBW LB麦克纳姆轮 未选型
color([0.9294117647058824, 0.596078431372549, 0.1843137254901961],0.5) translate([-132, 48, 30]) cube([30, 60, 60],center=true);
// R01 R脚部检修盖 暂定
if(show_shell) color([0.7450980392156863, 0.803921568627451, 0.8274509803921568],0.5) translate([69, 0, 88]) cube([84, 150, 4],center=true);
// R02 R双路轮驱动板 未设计
color([0.16470588235294117, 0.611764705882353, 0.45098039215686275],0.5) translate([69, 0, 69]) cube([64, 54, 16],center=true);
// R03 R电机承力托架 暂定
if(show_shell) color([0.7450980392156863, 0.803921568627451, 0.8274509803921568],0.5) translate([69, 0, 46]) cube([84, 150, 67],center=true);
// RFM RF轮电机 #4846 已知外包络
color([0.3254901960784314, 0.6, 0.7725490196078432],0.5) translate([69, -48, 30]) cube([69, 25, 25],center=true);
// RFC RF输出轴/联轴器 暂定
color([0.4627450980392157, 0.5058823529411764, 0.5568627450980392],0.5) translate([110, -48, 30]) cube([13, 16, 16],center=true);
// RFA RF承重轴承座 暂定
color([0.4627450980392157, 0.5058823529411764, 0.5568627450980392],0.5) translate([119, -48, 30]) cube([5, 24, 24],center=true);
// RFW RF麦克纳姆轮 未选型
color([0.9294117647058824, 0.596078431372549, 0.1843137254901961],0.5) translate([132, -48, 30]) cube([30, 60, 60],center=true);
// RBM RB轮电机 #4846 已知外包络
color([0.3254901960784314, 0.6, 0.7725490196078432],0.5) translate([69, 48, 30]) cube([69, 25, 25],center=true);
// RBC RB输出轴/联轴器 暂定
color([0.4627450980392157, 0.5058823529411764, 0.5568627450980392],0.5) translate([110, 48, 30]) cube([13, 16, 16],center=true);
// RBA RB承重轴承座 暂定
color([0.4627450980392157, 0.5058823529411764, 0.5568627450980392],0.5) translate([119, 48, 30]) cube([5, 24, 24],center=true);
// RBW RB麦克纳姆轮 未选型
color([0.9294117647058824, 0.596078431372549, 0.1843137254901961],0.5) translate([132, 48, 30]) cube([30, 60, 60],center=true);
