qq2898498192-prog/codex/(list of files, cad)

Other CAD files:
microduck_rl/src/mjlab_microduck/robot/microduck/assets/ankle_r_v1.stl
microduck_rl/src/mjlab_microduck/robot/microduck/assets/foot_right.stl
microduck_rl/src/mjlab_microduck/robot/microduck/assets/left_upper_leg.stl
microduck_rl/src/mjlab_microduck/robot/microduck/assets/upper_leg_right.stl
microduck_rl/src/mjlab_microduck/robot/microduck/assets/upper_leg_left.stl
microduck_rl/src/mjlab_microduck/robot/microduck/assets/ankle_left.stl
microduck_rl/src/mjlab_microduck/robot/microduck/assets/sole_right.stl
