qq2898498192-prog/codex/projects/microduck-pet-v2/docs/CHANGELOG.md

# 修改记录

此为需求演变顺序，非逐条真实时间戳。归档日期2026-09-09。

1. 放弃完全复刻Microduck，探索宠物机器人；最初提出轮式、屏幕、摄像头和测距。
2. 多个新ID被用户否定，回到鸭子形象。
3. 保留鸭子身体，更换带小屏的头；随后要求小摄像头、大屏。
4. 用户强调模组尺寸，增加头部V1布局；真实显示区小于之前图片。
5. 切换原仓库轮滑脚。AI图被质疑，核对MJCF确认分支是4个被动轮，但不能断言对应用户见过的原厂实物。
6. 临时恢复摄像头头部，去掉脚踝舵机，试用被动万向脚轮；被用户认为丑。
7. 改四台电机驱动大麦克纳姆轮，整合脚部轮罩。
8. 用户要求重做腿部安装/线束、按重量选电机，恢复屏幕头并去嘴；初选3kg、80mm轮、Pololu4846。
9. 用户要求更小轮子，改约60mm比例；用户认为变化不明显。
10. 用户明确取消嘴巴、取消头部俯仰，只保留左右转头；制作简化10秒视频。
11. 做42项内部包络布局，补电池/主控/驱动/转台/轴承/线束，暴露294mm底宽，估算重量改3.5kg。
12. 用户要求整个外观的爆炸图，生成整机概念爆炸效果；修正第一次生成的8轮错误。最终图依旧不是工程依据。
13. 制作Three.js拖动爆炸试验；用户要求基于整机效果图，否定简化模型。该高还原度三维装配体尚未建成。
14. 用户授权将新方案、修改与对话归档GitHub新分支。本次只归档和修正状态说明，不冒充已完成实际CAD、PCB或仿真。

## 归档中的可复用性修正

- 为交互片段添加独立浏览器入口和基础样式。
- 视频脚本的字体改为命令行参数/环境变量/系统字体回退，去掉工作区专属路径。
- 生成脚本保留原实现于archive，单独指出绝对路径与假设，不覆盖已经展示的历史结果。
- 上游microduck_rl内容不变；新方案放在projects/microduck-pet-v2。
