qq2898498192-prog/codex/(commit log)

2026-09-07 docs: import upstream reference print_bom.csv
    [print_bom.csv]
2026-09-07 docs: import upstream reference imu_to_dxl_v0_bom.csv
    [imu_to_dxl_v0_bom.csv]
2026-09-07 docs: import upstream reference assembly_and_wiring.md
2026-09-07 docs: import upstream reference microduck_bom.csv
    [microduck_bom.csv]
2026-09-07 docs: import upstream reference reference_bom.csv
    [reference_bom.csv]
2026-09-07 docs: import upstream reference imu_to_dxl_v0_bringup.md
2026-09-07 docs: import upstream reference work_plan.csv
    [work_plan.csv]
2026-09-07 docs: import reference with private project and order metadata omitted
    [purchase_bom.csv]
2026-09-07 Copy complete public Microduck project at 57280a0 (253 files)
    [ankle_l_v1.stl, ankle_left.stl, ankle_r_v1.stl, ankle_right.stl, arm.stl, asset_manifest.csv, axis.stl, banana_pcb_locker.stl]
2026-09-09 stage design archive 1/41
2026-09-09 stage design archive 2/41
2026-09-09 stage design archive 3/41
2026-09-09 stage design archive 4/41
2026-09-09 stage design archive 5/41
2026-09-09 stage design archive 6/41
2026-09-09 stage design archive 7/41
2026-09-09 stage design archive 8/41
2026-09-09 stage design archive 9/41
2026-09-09 stage design archive 10/41
2026-09-09 stage design archive 11/41
2026-09-09 stage design archive 12/41
2026-09-09 stage design archive 13/41
2026-09-09 stage design archive 14/41
2026-09-09 stage design archive 15/41
2026-09-09 stage design archive 16/41
2026-09-09 stage design archive 17/41
2026-09-09 stage design archive 18/41
2026-09-09 stage design archive 19/41
2026-09-09 stage design archive 20/41
2026-09-09 stage design archive 21/41
2026-09-09 stage design archive 22/41
2026-09-09 stage design archive 23/41
2026-09-09 stage design archive 24/41
2026-09-09 stage design archive 25/41
2026-09-09 stage design archive 26/41
2026-09-09 stage design archive 27/41
2026-09-09 stage design archive 28/41
2026-09-09 stage design archive 29/41
2026-09-09 stage design archive 30/41
2026-09-09 stage design archive 31/41
2026-09-09 stage design archive 32/41
2026-09-09 stage design archive 33/41
2026-09-09 stage design archive 34/41
2026-09-09 stage design archive 35/41
2026-09-09 stage design archive 36/41
2026-09-09 stage design archive 37/41
2026-09-09 stage design archive 38/41
2026-09-09 stage design archive 39/41
2026-09-09 stage design archive 40/41
2026-09-09 stage design archive 41/41
2026-09-09 Archive robot redesign, assets, change log and conversation
    [layout_envelopes.scad, parts.csv]
